LZajmi/Artix-7-FPGA-Dev-Board/ddr3.kicad_sch

## KiCad design ddr3.kicad_sch (2024-09-25)

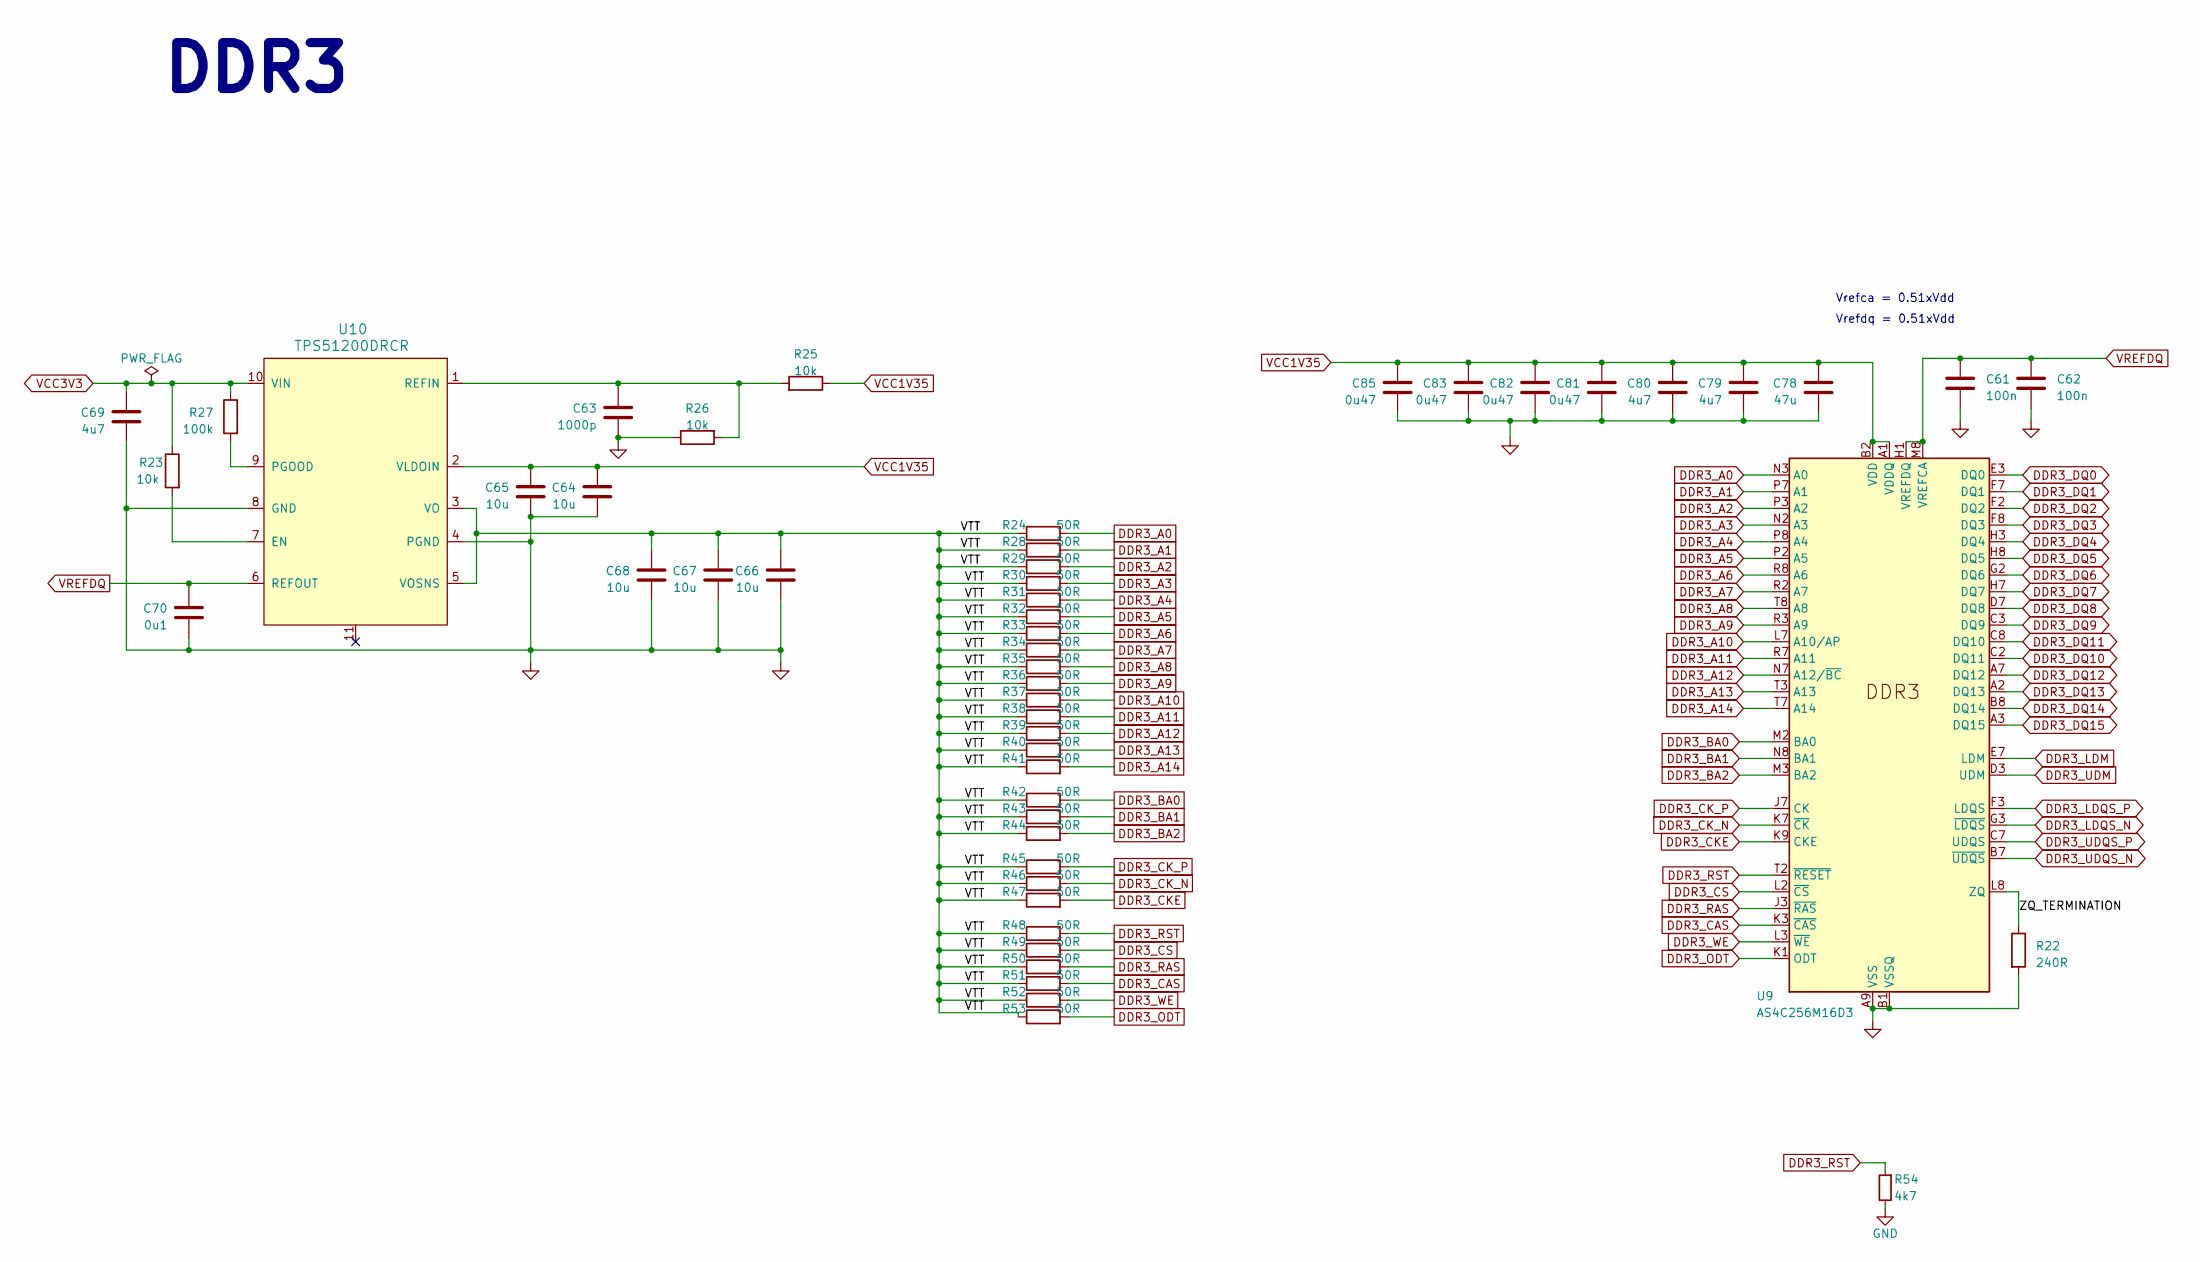
[picture p1: schematic ddr3.kicad_sch]

Parts:
C61, C62: 100n; G-155_MUR
C63: 1000p; CAP_GRM_155_MUR
C64, C65, C66, C67, C68: 10u; CAP_GRM155R60J106ME05D_MUR
C69, C79, C80: 4u7; CAPC2012X140N
C70: 0u1; G-155_MUR
C78: 47u; G-32_MUR
C81, C82, C83, C85: 0u47; CAPC1005X55N
R22: 240R; RES_ERA2AEB241X
R23, R25, R26: 10k; RESC1005X40N
R24, R28, R29, R30, R31, R32, R33, R34, R35, R36, R37, R38, R39, R40, R41, R42, R43, R44, R45, R46, R47, R48, R49, R50, R51, R52, R53: 50R; RESC1005X40N
R27: 100k; RESC1608X55
R54: R_4k7_0402; RESC1005X40; Tolerance 1%; MPN CR0402-FX-4701GLF
U9: AS4C256M16D3; BGA-96_9.0x13.0mm_Layout2x3x16_P0.8mm
U10: TPS51200DRCR; VSON-10-1EP_3x3mm; MPN TPS51200DRCR; Digi-Key_PN 296-26978-1-ND

Connections:
DDR3_A0: R24.2, U9.N3 (A0)
DDR3_A1: R28.2, U9.P7 (A1)
DDR3_A2: R29.2, U9.P3 (A2)
DDR3_A3: R30.2, U9.N2 (A3)
DDR3_A4: R31.2, U9.P8 (A4)
DDR3_A5: R32.2, U9.P2 (A5)
DDR3_A6: R33.2, U9.R8 (A6)
DDR3_A7: R34.2, U9.R2 (A7)
DDR3_A8: R35.2, U9.T8 (A8)
DDR3_A9: R36.2, U9.R3 (A9)
DDR3_A10: R37.2, U9.L7 (A10/AP)
DDR3_A11: R38.2, U9.R7 (A11)
DDR3_A12: R39.2, U9.N7 (A12/~BC)
DDR3_A13: R40.2, U9.T3 (A13)
DDR3_A14: R41.2, U9.T7 (A14)
DDR3_BA0: R42.2, U9.M2 (BA0)
DDR3_BA1: R43.2, U9.N8 (BA1)
DDR3_BA2: R44.2, U9.M3 (BA2)
DDR3_CAS: R51.2, U9.K3 (~CAS)
DDR3_CKE: R47.2, U9.K9 (CKE)
DDR3_CK_N: R46.2, U9.K7 (~CK)
DDR3_CK_P: R45.2, U9.J7 (CK)
DDR3_CS: R49.2, U9.L2 (~CS)
DDR3_DQ0: U9.E3 (DQ0)
DDR3_DQ1: U9.F7 (DQ1)
DDR3_DQ2: U9.F2 (DQ2)
DDR3_DQ3: U9.F8 (DQ3)
DDR3_DQ4: U9.H3 (DQ4)
DDR3_DQ5: U9.H8 (DQ5)
DDR3_DQ6: U9.G2 (DQ6)
DDR3_DQ7: U9.H7 (DQ7)
DDR3_DQ8: U9.D7 (DQ8)
DDR3_DQ9: U9.C3 (DQ9)
DDR3_DQ10: U9.C2 (DQ11)
DDR3_DQ11: U9.C8 (DQ10)
DDR3_DQ12: U9.A7 (DQ12)
DDR3_DQ13: U9.A2 (DQ13)
DDR3_DQ14: U9.B8 (DQ14)
DDR3_DQ15: U9.A3 (DQ15)
DDR3_LDM: U9.E7 (LDM)
DDR3_LDQS_N: U9.G3 (~LDQS)
DDR3_LDQS_P: U9.F3 (LDQS)
DDR3_ODT: R53.2, U9.K1 (ODT)
DDR3_RAS: R50.2, U9.J3 (~RAS)
DDR3_RST: R48.2, R54.1, U9.T2 (~RESET)
DDR3_UDM: U9.D3 (UDM)
DDR3_UDQS_N: U9.B7 (~UDQS)
DDR3_UDQS_P: U9.C7 (UDQS)
DDR3_WE: R52.2, U9.L3 (~WE)
GND: C61.2, C62.2, C63.2, C64.2, C65.2, C66.2, C67.2, C68.2, C69.2, C70.2, C78.1, C79.1, C80.1, C81.1, C82.1, C83.1, C85.1, R22.2, R26.1, R54.2, U9.A9 (VSS), U9.B1 (VSSQ), U9.B3 (VSS), U9.B9 (VSSQ), U9.D1 (VSSQ), U9.D8 (VSSQ), U9.E1 (VSS), U9.E2 (VSSQ), U9.E8 (VSSQ), U9.F9 (VSSQ), U9.G1 (VSSQ), U9.G8 (VSS), U9.G9 (VSSQ), U9.J2 (VSS), U9.J8 (VSS), U9.M1 (VSS), U9.M9 (VSS), U9.P1 (VSS), U9.P9 (VSS), U9.T1 (VSS), U9.T9 (VSS), U10.4 (PGND), U10.8 (GND)
unnamed: C63.1, R25.2, R26.2, U10.1 (REFIN)
unnamed: R23.2, U10.7 (EN)
unnamed: R27.2, U10.9 (PGOOD)
VCC1V35: C64.1, C65.1, C78.2, C79.2, C80.2, C81.2, C82.2, C83.2, C85.2, R25.1, U9.A1 (VDDQ), U9.A8 (VDDQ), U9.B2 (VDD), U9.C1 (VDDQ), U9.C9 (VDDQ), U9.D2 (VDDQ), U9.D9 (VDD), U9.E9 (VDDQ), U9.F1 (VDDQ), U9.G7 (VDD), U9.H2 (VDDQ), U9.H9 (VDDQ), U9.K2 (VDD), U9.K8 (VDD), U9.N1 (VDD), U9.N9 (VDD), U9.R1 (VDD), U9.R9 (VDD), U10.2 (VLDOIN)
VCC3V3: C69.1, R23.1, R27.1, U10.10 (VIN)
VREFDQ: C61.1, C62.1, C70.1, U9.H1 (VREFDQ), U9.M8 (VREFCA), U10.6 (REFOUT)
VTT: C66.1, C67.1, C68.1, R24.1, R28.1, R29.1, R30.1, R31.1, R32.1, R33.1, R34.1, R35.1, R36.1, R37.1, R38.1, R39.1, R40.1, R41.1, R42.1, R43.1, R44.1, R45.1, R46.1, R47.1, R48.1, R49.1, R50.1, R51.1, R52.1, R53.1, U10.3 (VO), U10.5 (VOSNS)
ZQ_TERMINATION: R22.1, U9.L8 (ZQ)

Notes on the sheet:
Vrefdq = 0.51xVdd
DDR3
Vrefca = 0.51xVdd
