LZajmi/Artix-7-FPGA-Dev-Board/ethernet.kicad_sch

## KiCad design ethernet.kicad_sch (2024-09-25)

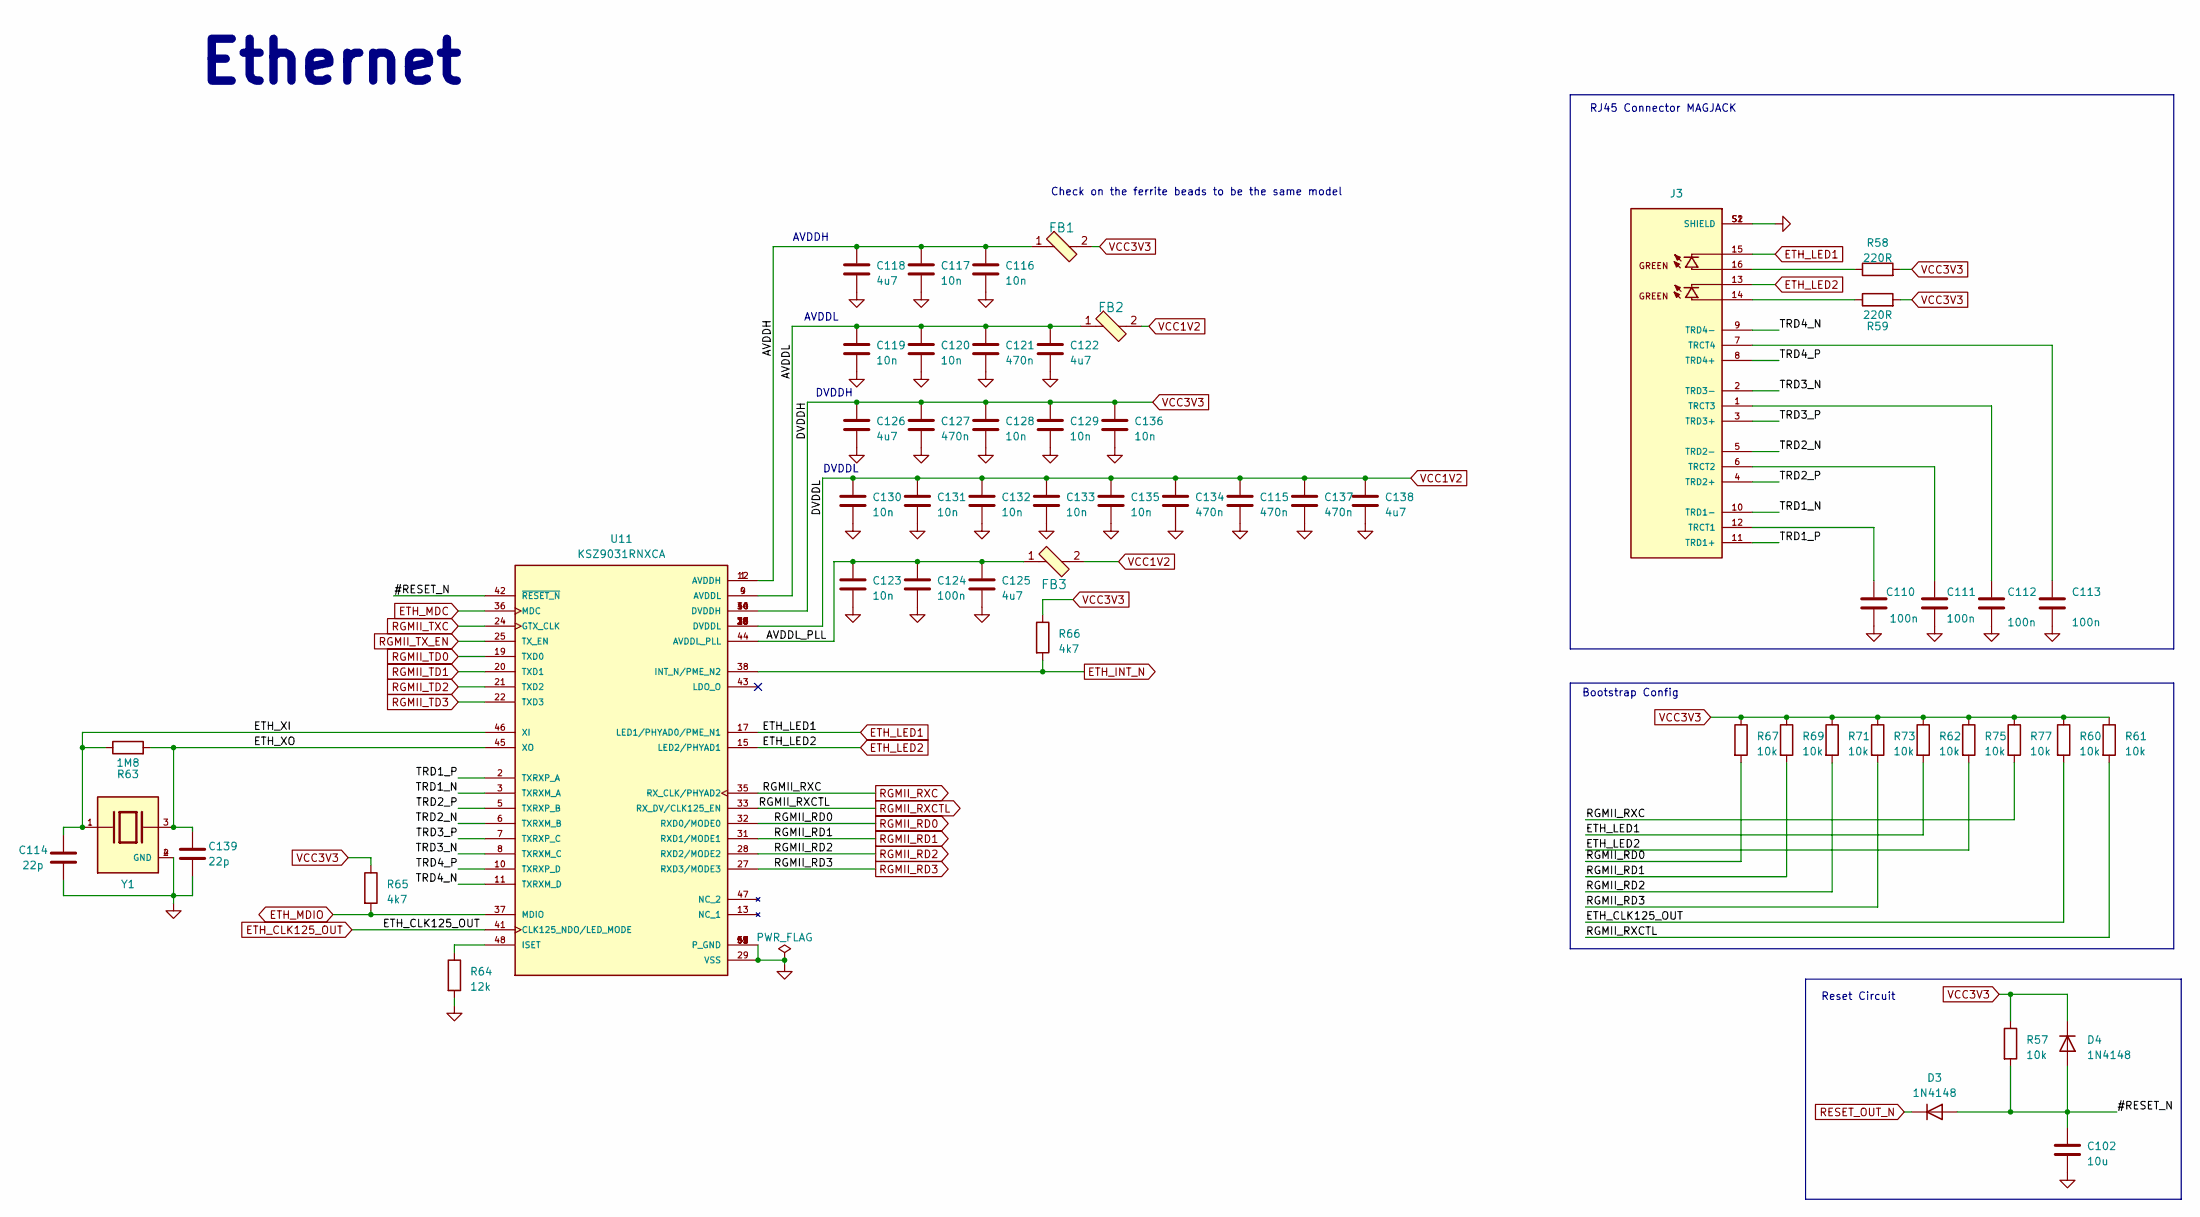
[picture p2: schematic ethernet.kicad_sch]

Parts:
C102: 10u; CAP_GRM155R60J106ME05D_MUR
C110, C111, C112, C113, C124: 100n; G-155_MUR
C114, C139: 22p; CAPC1005X55N
C115, C121, C127, C134, C137: 470n; CAPC1005X55N
C116, C117, C119, C120, C123, C128, C129, C130, C131, C132, C133, C135, C136: 10n; CAPC1005X55N
C118, C122, C125, C126, C138: 4u7; CAPC2012X140N
D3, D4: 1N4148; SOD123
FB1, FB2, FB3: BLM18PG121SN1D; IND_BLM18_0603_MUR; MPN BLM18PG121SN1D; Digi-Key_PN 490-1037-1-ND
J3: L834-1G1T-S7; BEL_L834-1G1T-S7
R57, R60, R61, R62, R67, R69, R71, R73, R75, R77: 10k; RESC1005X40N
R58, R59: 220R; RESC1005X35N
R63: 1M8; RESC1608X55N
R64: 12k; RESC1005X40N
R65, R66: 4k7; RESC1005X40
U11: KSZ9031RNXCA; QFN50P700X700X90-49N
Y1: ABM8G-27.000MHZ-18-D2Y-T; XTAL_ABM8G-27.000MHZ-18-D2Y-T; PARTREV 08.13.15

Connections:
#RESET_N: C102.1, D3.2 (A), D4.2 (A), R57.2, U11.42 (~RESET_N)
AVDDH: C116.1, C117.1, C118.1, FB1.1, U11.1 (AVDDH), U11.12 (AVDDH)
AVDDL: C119.1, C120.1, C121.1, C122.1, FB2.1, U11.4 (AVDDL), U11.9 (AVDDL)
AVDDL_PLL: C123.1, C124.1, C125.1, FB3.1, U11.44 (AVDDL_PLL)
ETH_CLK125_OUT: R60.2, U11.41 (CLK125_NDO/LED_MODE)
ETH_INT_N: R66.2, U11.38 (INT_N/PME_N2)
ETH_LED1: J3.15, R62.2, U11.17 (LED1/PHYAD0/PME_N1)
ETH_LED2: J3.13, R75.2, U11.15 (LED2/PHYAD1)
ETH_MDC: U11.36 (MDC)
ETH_MDIO: R65.2, U11.37 (MDIO)
ETH_XI: C114.1, R63.1, U11.46 (XI), Y1.1
ETH_XO: C139.1, R63.2, U11.45 (XO), Y1.3
GND: C102.2, C110.2, C111.2, C112.2, C113.2, C114.2, C115.2, C116.2, C117.2, C118.2, C119.2, C120.2, C121.2, C122.2, C123.2, C124.2, C125.2, C126.2, C127.2, C128.2, C129.2, C130.2, C131.2, C132.2, C133.2, C134.2, C135.2, C136.2, C137.2, C138.2, C139.2, J3.S1 (SHIELD), J3.S2 (SHIELD), R64.2, U11.29 (VSS), U11.49 (P_GND), U11.50 (P_GND), U11.51 (P_GND), U11.52 (P_GND), U11.53 (P_GND), Y1.2 (GND), Y1.4 (GND)
unnamed: C110.1, J3.12 (TRCT1)
unnamed: C111.1, J3.6 (TRCT2)
unnamed: C112.1, J3.1 (TRCT3)
unnamed: C113.1, J3.7 (TRCT4)
unnamed: J3.14, R59.1
unnamed: J3.16, R58.1
unnamed: R64.1, U11.48 (ISET)
RESET_OUT_N: D3.1 (K)
RGMII_RD0: R67.2, U11.32 (RXD0/MODE0)
RGMII_RD1: R69.2, U11.31 (RXD1/MODE1)
RGMII_RD2: R71.2, U11.28 (RXD2/MODE2)
RGMII_RD3: R73.2, U11.27 (RXD3/MODE3)
RGMII_RXC: R77.2, U11.35 (RX_CLK/PHYAD2)
RGMII_RXCTL: R61.2, U11.33 (RX_DV/CLK125_EN)
RGMII_TD0: U11.19 (TXD0)
RGMII_TD1: U11.20 (TXD1)
RGMII_TD2: U11.21 (TXD2)
RGMII_TD3: U11.22 (TXD3)
RGMII_TXC: U11.24 (GTX_CLK)
RGMII_TX_EN: U11.25 (TX_EN)
TRD1_N: J3.10 (TRD1-), U11.3 (TXRXM_A)
TRD1_P: J3.11 (TRD1+), U11.2 (TXRXP_A)
TRD2_N: J3.5 (TRD2-), U11.6 (TXRXM_B)
TRD2_P: J3.4 (TRD2+), U11.5 (TXRXP_B)
TRD3_N: J3.2 (TRD3-), U11.8 (TXRXM_C)
TRD3_P: J3.3 (TRD3+), U11.7 (TXRXP_C)
TRD4_N: J3.9 (TRD4-), U11.11 (TXRXM_D)
TRD4_P: J3.8 (TRD4+), U11.10 (TXRXP_D)
VCC1V2: C115.1, C130.1, C131.1, C132.1, C133.1, C134.1, C135.1, C137.1, C138.1, FB2.2, FB3.2, U11.14 (DVDDL), U11.18 (DVDDL), U11.23 (DVDDL), U11.26 (DVDDL), U11.30 (DVDDL), U11.39 (DVDDL)
VCC3V3: C126.1, C127.1, C128.1, C129.1, C136.1, D4.1 (K), FB1.2, R57.1, R58.2, R59.2, R60.1, R61.1, R62.1, R65.1, R66.1, R67.1, R69.1, R71.1, R73.1, R75.1, R77.1, U11.16 (DVDDH), U11.34 (DVDDH), U11.40 (DVDDH)

Notes on the sheet:
AVDDL
DVDDL
Reset Circuit
Bootstrap Config
AVDDH
Ethernet
Check on the ferrite beads to be the same model
DVDDH
RJ45 Connector MAGJACK
