LZajmi/Artix-7-FPGA-Dev-Board/fpga-banks-13-16.kicad_sch

## KiCad design fpga-banks-13-16.kicad_sch (2024-09-25)

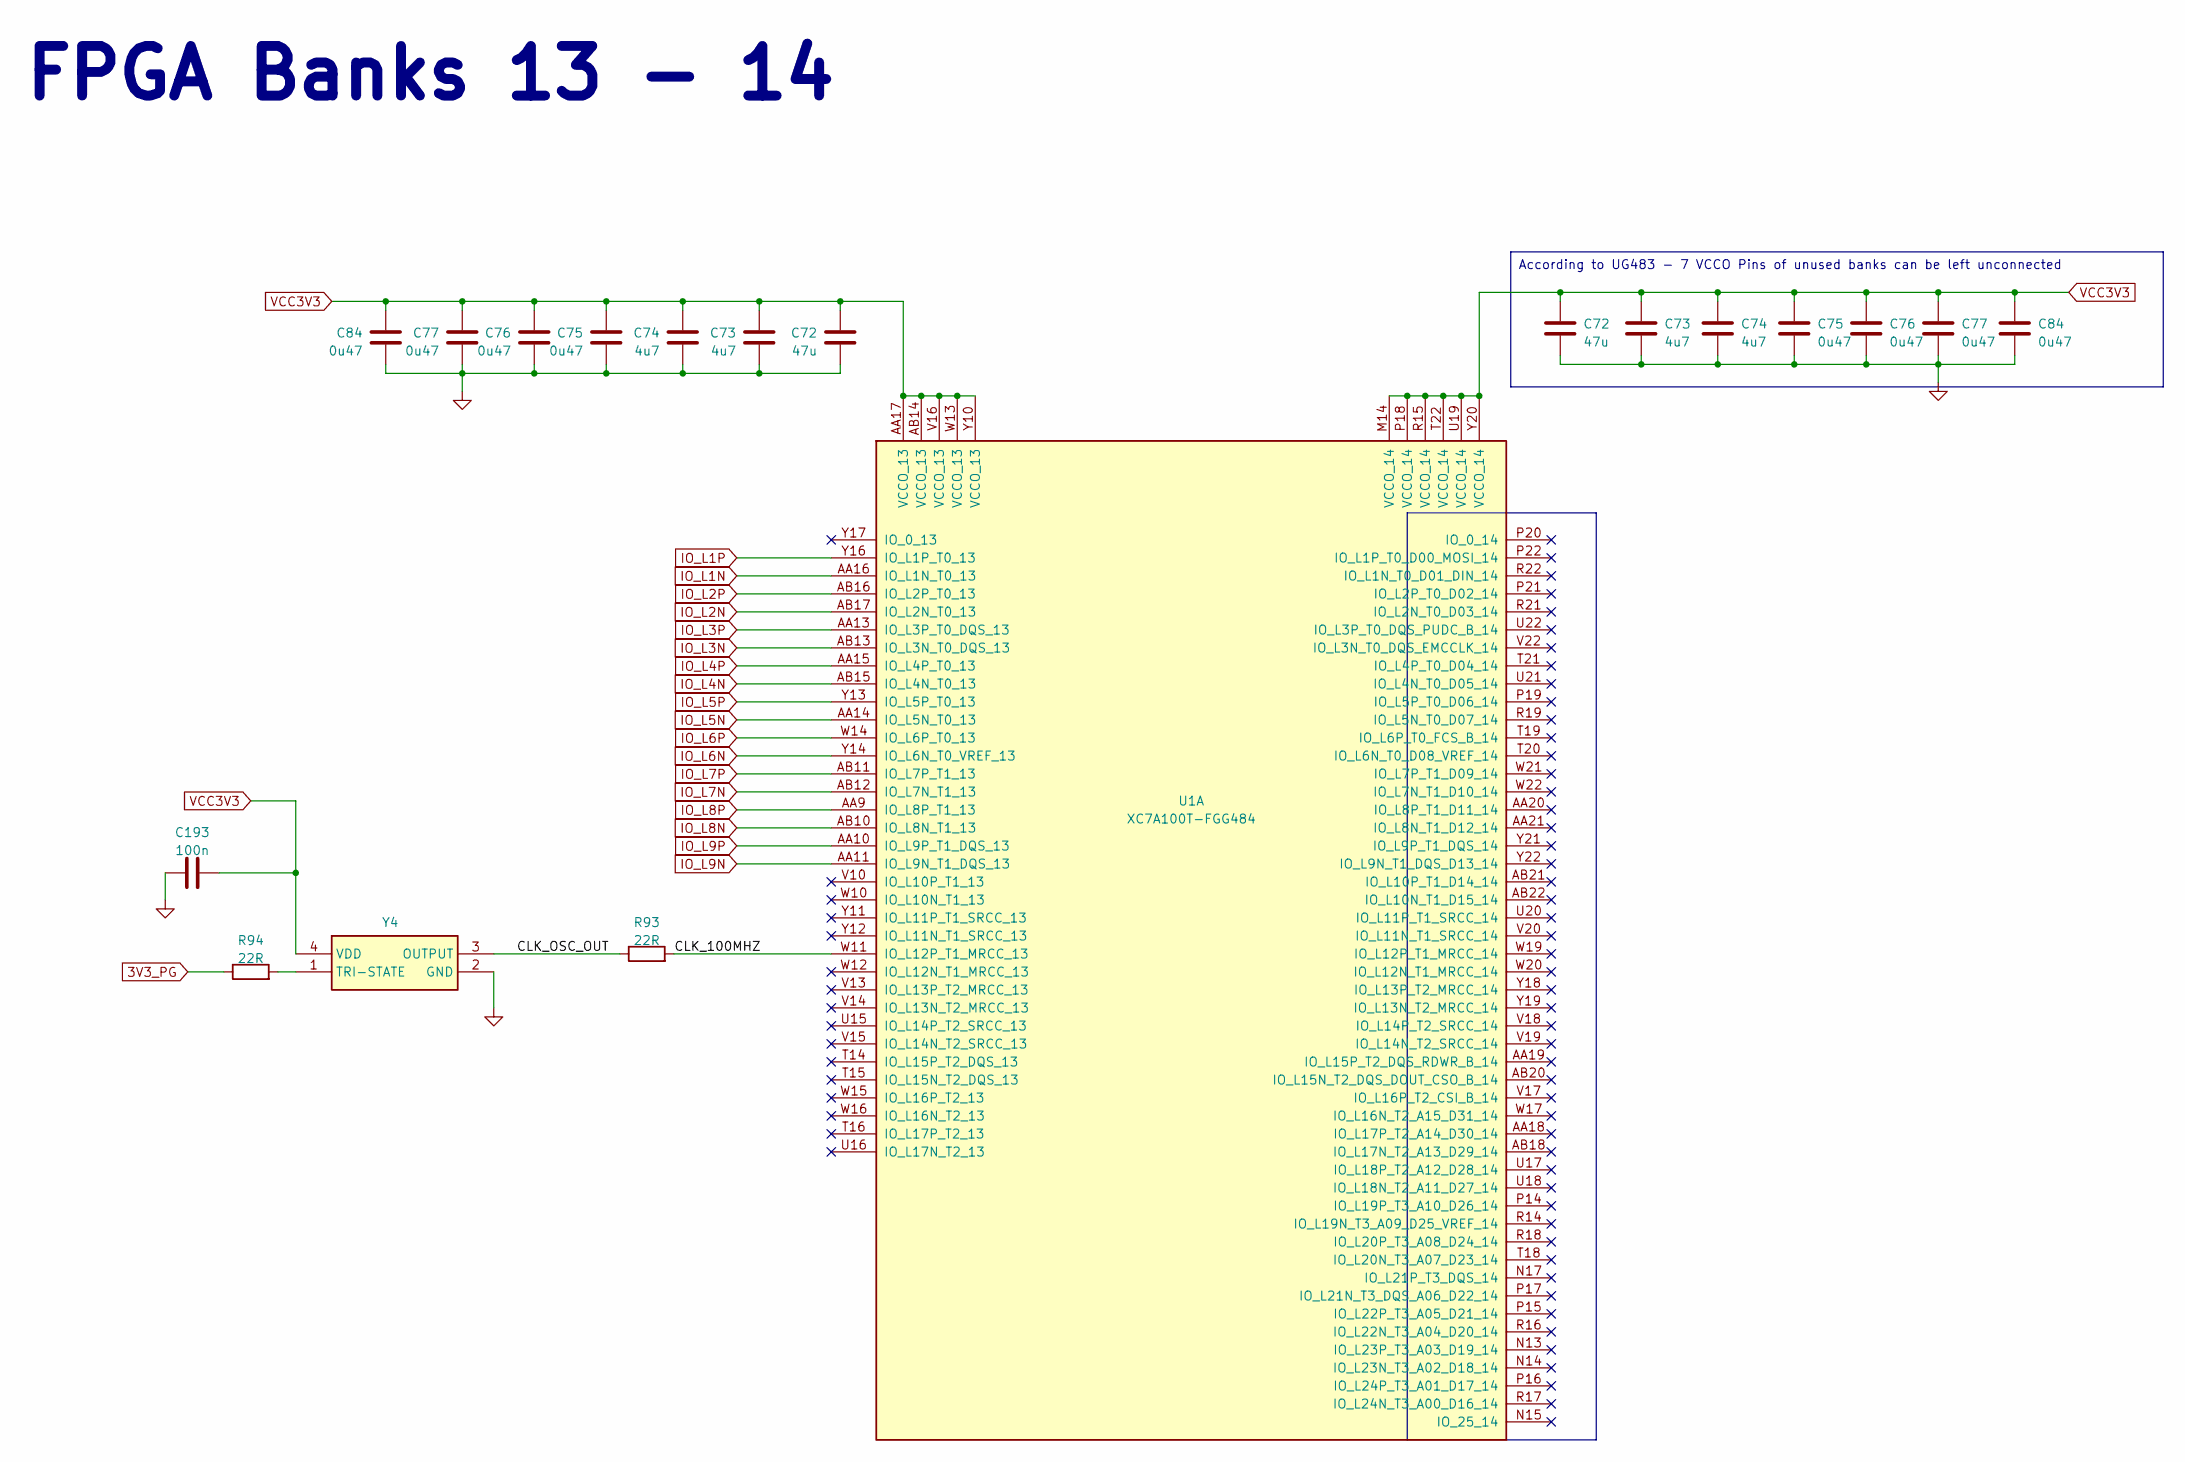
[picture p3: schematic fpga-banks-13-16.kicad_sch]

Parts:
C72: 47u; G-32_MUR
C73, C74: 4u7; CAPC2012X140N
C75, C76, C77, C84: 0u47; CAPC1005X55N
C193: 100n; G-155_MUR
R93, R94: 22R; RC0402N_YAG
U1: XC7A100T-FGG484; BGA484C100P22X22_2300X2300X260N
Y4: ECS-2520MV-130-BN-TR; ECS2520MV130BNTR; Mouser Part Number 520-S2520MV130BNTR

Connections:
3V3_PG: R94.1
CLK_100MHZ: R93.2, U1.W11 (IO_L12P_T1_MRCC_13)
CLK_OSC_OUT: R93.1, Y4.3 (OUTPUT)
GND: C72.1, C73.1, C74.1, C75.1, C76.1, C77.1, C84.1, C193.1, Y4.2 (GND)
IO_L1N: U1.AA16 (IO_L1N_T0_13)
IO_L1P: U1.Y16 (IO_L1P_T0_13)
IO_L2N: U1.AB17 (IO_L2N_T0_13)
IO_L2P: U1.AB16 (IO_L2P_T0_13)
IO_L3N: U1.AB13 (IO_L3N_T0_DQS_13)
IO_L3P: U1.AA13 (IO_L3P_T0_DQS_13)
IO_L4N: U1.AB15 (IO_L4N_T0_13)
IO_L4P: U1.AA15 (IO_L4P_T0_13)
IO_L5N: U1.AA14 (IO_L5N_T0_13)
IO_L5P: U1.Y13 (IO_L5P_T0_13)
IO_L6N: U1.Y14 (IO_L6N_T0_VREF_13)
IO_L6P: U1.W14 (IO_L6P_T0_13)
IO_L7N: U1.AB12 (IO_L7N_T1_13)
IO_L7P: U1.AB11 (IO_L7P_T1_13)
IO_L8N: U1.AB10 (IO_L8N_T1_13)
IO_L8P: U1.AA9 (IO_L8P_T1_13)
IO_L9N: U1.AA11 (IO_L9N_T1_DQS_13)
IO_L9P: U1.AA10 (IO_L9P_T1_DQS_13)
unnamed: R94.2, Y4.1 (TRI-STATE)
VCC3V3: C72.2, C73.2, C74.2, C75.2, C76.2, C77.2, C84.2, C193.2, U1.AA17 (VCCO_13), U1.AB14 (VCCO_13), U1.M14 (VCCO_14), U1.P18 (VCCO_14), U1.R15 (VCCO_14), U1.T22 (VCCO_14), U1.U19 (VCCO_14), U1.V16 (VCCO_13), U1.W13 (VCCO_13), U1.Y10 (VCCO_13), U1.Y20 (VCCO_14), Y4.4 (VDD)

Notes on the sheet:
According to UG483 - 7 VCCO Pins of unused banks can be left unconnected
FPGA Banks 13 - 14
