LZajmi/Artix-7-FPGA-Dev-Board/fpga-unit-b.kicad_sch

## KiCad design fpga-unit-b.kicad_sch (2024-09-25)

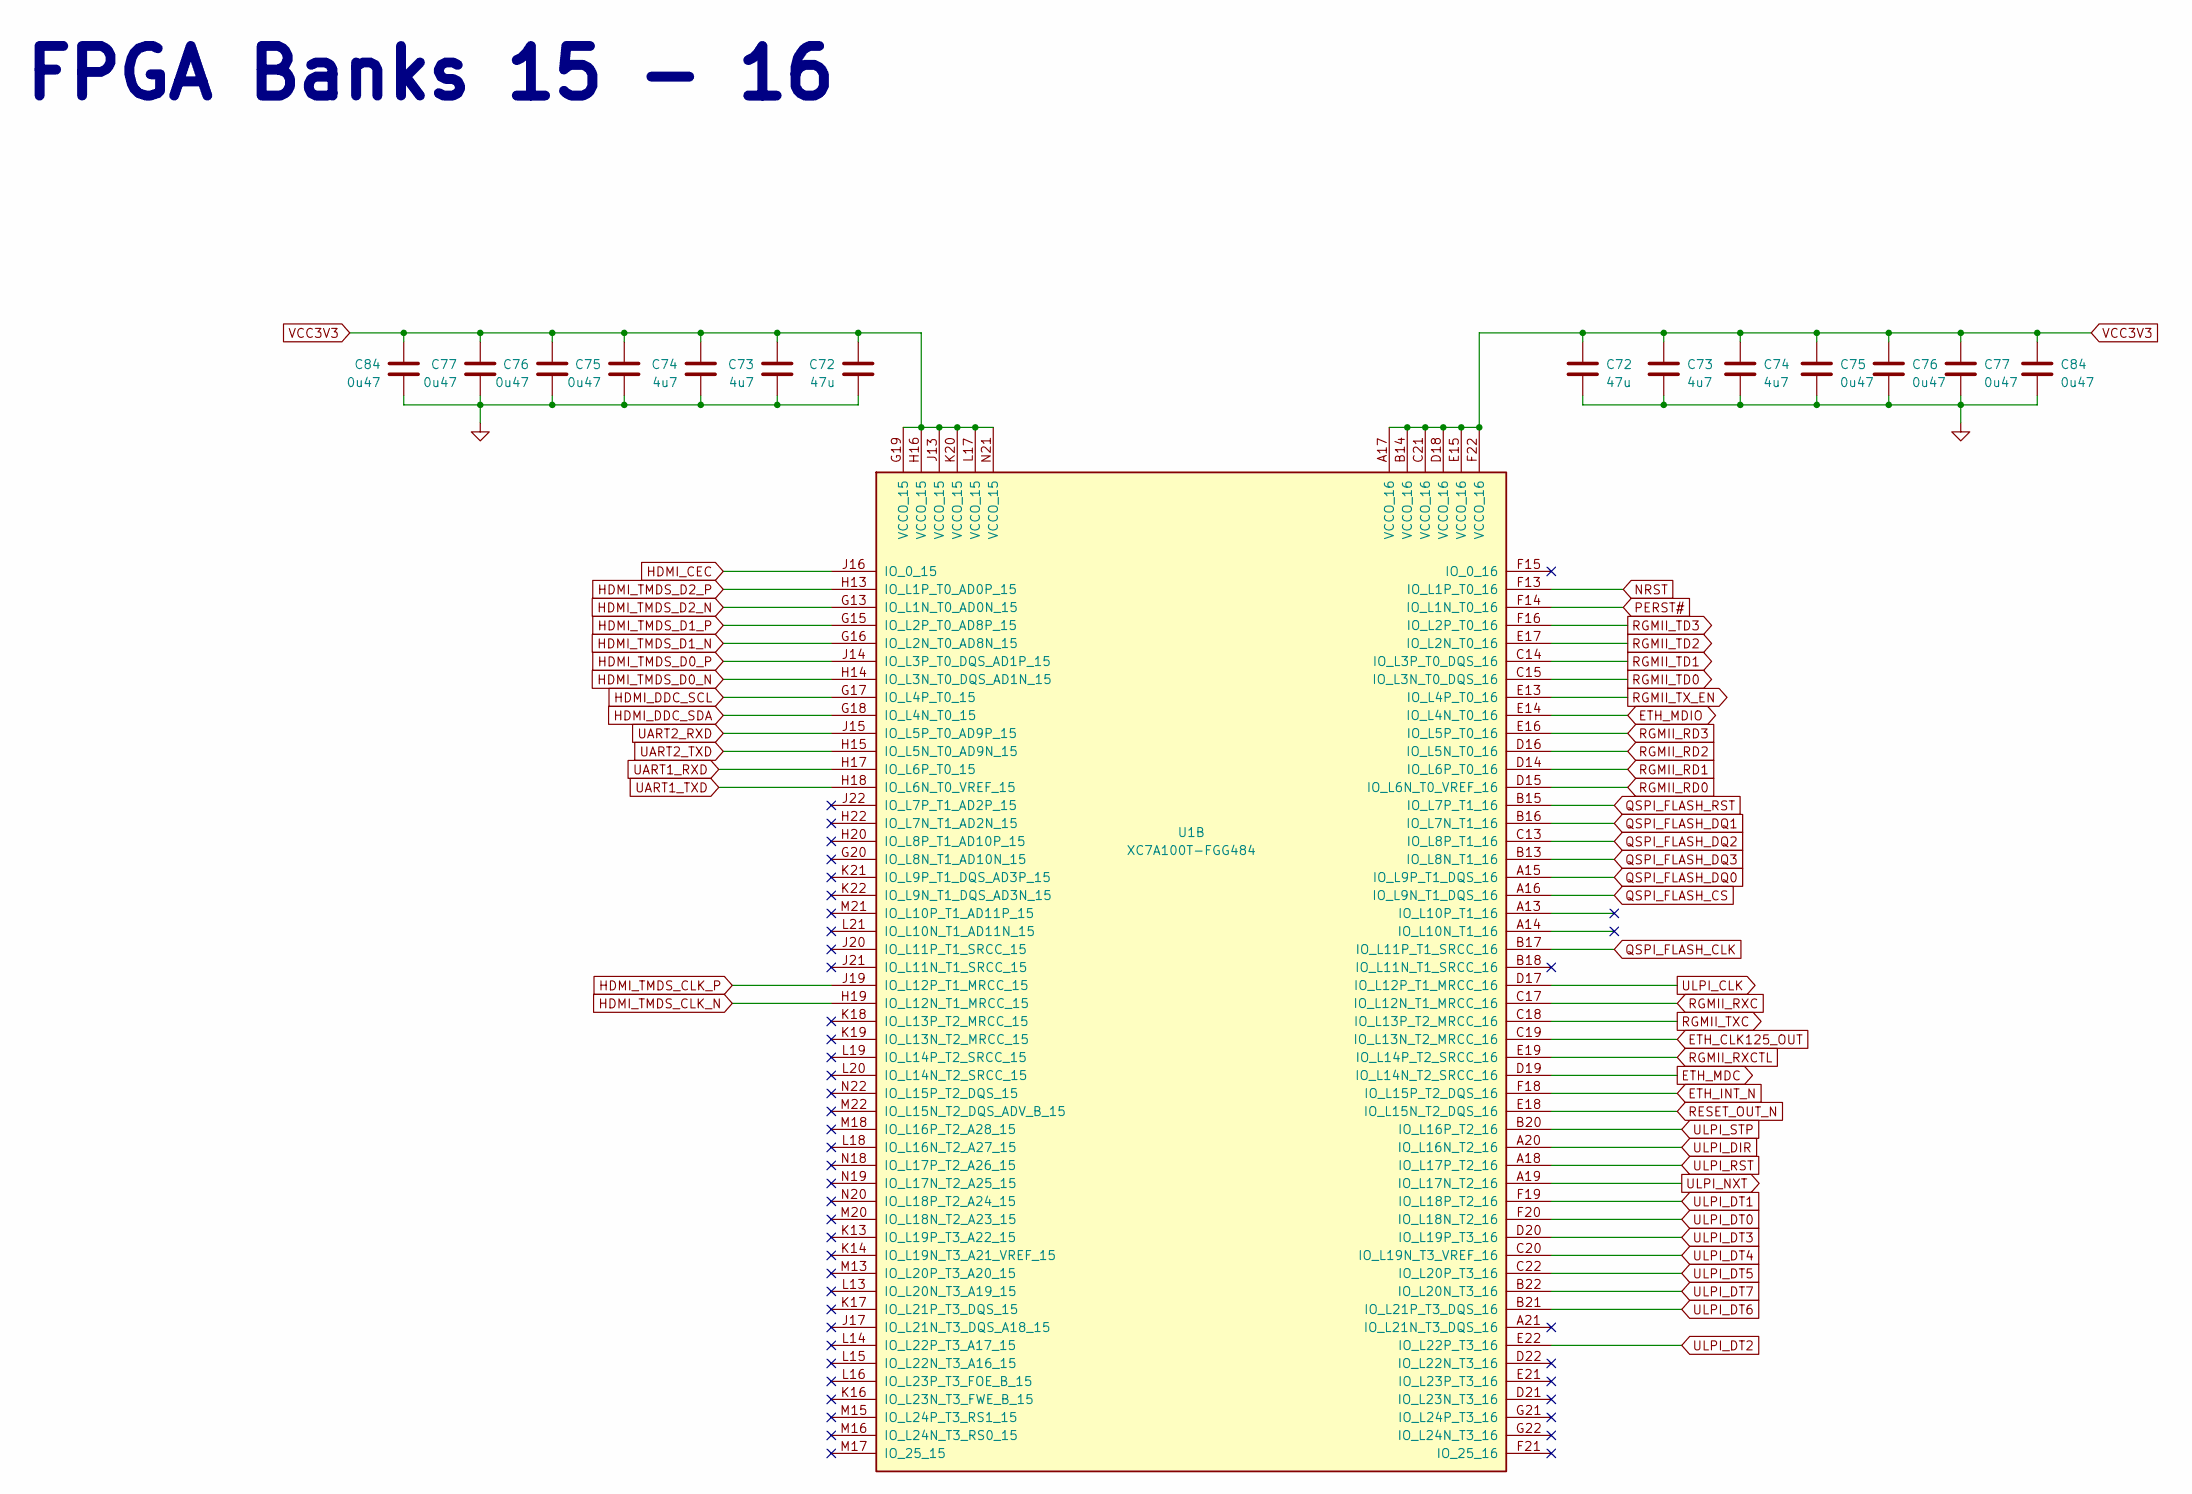
[picture p4: schematic fpga-unit-b.kicad_sch]

Parts:
C72: 47u; G-32_MUR
C73, C74: 4u7; CAPC2012X140N
C75, C76, C77, C84: 0u47; CAPC1005X55N
U1: XC7A100T-FGG484; BGA484C100P22X22_2300X2300X260N

Connections:
ETH_CLK125_OUT: U1.C19 (IO_L13N_T2_MRCC_16)
ETH_INT_N: U1.F18 (IO_L15P_T2_DQS_16)
ETH_MDC: U1.D19 (IO_L14N_T2_SRCC_16)
ETH_MDIO: U1.E14 (IO_L4N_T0_16)
GND: C72.1, C73.1, C74.1, C75.1, C76.1, C77.1, C84.1
HDMI_CEC: U1.J16 (IO_0_15)
HDMI_DDC_SCL: U1.G17 (IO_L4P_T0_15)
HDMI_DDC_SDA: U1.G18 (IO_L4N_T0_15)
HDMI_TMDS_CLK_N: U1.H19 (IO_L12N_T1_MRCC_15)
HDMI_TMDS_CLK_P: U1.J19 (IO_L12P_T1_MRCC_15)
HDMI_TMDS_D0_N: U1.H14 (IO_L3N_T0_DQS_AD1N_15)
HDMI_TMDS_D0_P: U1.J14 (IO_L3P_T0_DQS_AD1P_15)
HDMI_TMDS_D1_N: U1.G16 (IO_L2N_T0_AD8N_15)
HDMI_TMDS_D1_P: U1.G15 (IO_L2P_T0_AD8P_15)
HDMI_TMDS_D2_N: U1.G13 (IO_L1N_T0_AD0N_15)
HDMI_TMDS_D2_P: U1.H13 (IO_L1P_T0_AD0P_15)
NRST: U1.F13 (IO_L1P_T0_16)
PERST#: U1.F14 (IO_L1N_T0_16)
QSPI_FLASH_CLK: U1.B17 (IO_L11P_T1_SRCC_16)
QSPI_FLASH_CS: U1.A16 (IO_L9N_T1_DQS_16)
QSPI_FLASH_DQ0: U1.A15 (IO_L9P_T1_DQS_16)
QSPI_FLASH_DQ1: U1.B16 (IO_L7N_T1_16)
QSPI_FLASH_DQ2: U1.C13 (IO_L8P_T1_16)
QSPI_FLASH_DQ3: U1.B13 (IO_L8N_T1_16)
QSPI_FLASH_RST: U1.B15 (IO_L7P_T1_16)
RESET_OUT_N: U1.E18 (IO_L15N_T2_DQS_16)
RGMII_RD0: U1.D15 (IO_L6N_T0_VREF_16)
RGMII_RD1: U1.D14 (IO_L6P_T0_16)
RGMII_RD2: U1.D16 (IO_L5N_T0_16)
RGMII_RD3: U1.E16 (IO_L5P_T0_16)
RGMII_RXC: U1.C17 (IO_L12N_T1_MRCC_16)
RGMII_RXCTL: U1.E19 (IO_L14P_T2_SRCC_16)
RGMII_TD0: U1.C15 (IO_L3N_T0_DQS_16)
RGMII_TD1: U1.C14 (IO_L3P_T0_DQS_16)
RGMII_TD2: U1.E17 (IO_L2N_T0_16)
RGMII_TD3: U1.F16 (IO_L2P_T0_16)
RGMII_TXC: U1.C18 (IO_L13P_T2_MRCC_16)
RGMII_TX_EN: U1.E13 (IO_L4P_T0_16)
UART1_RXD: U1.H17 (IO_L6P_T0_15)
UART1_TXD: U1.H18 (IO_L6N_T0_VREF_15)
UART2_RXD: U1.J15 (IO_L5P_T0_AD9P_15)
UART2_TXD: U1.H15 (IO_L5N_T0_AD9N_15)
ULPI_CLK: U1.D17 (IO_L12P_T1_MRCC_16)
ULPI_DIR: U1.A20 (IO_L16N_T2_16)
ULPI_DT0: U1.F20 (IO_L18N_T2_16)
ULPI_DT1: U1.F19 (IO_L18P_T2_16)
ULPI_DT2: U1.E22 (IO_L22P_T3_16)
ULPI_DT3: U1.D20 (IO_L19P_T3_16)
ULPI_DT4: U1.C20 (IO_L19N_T3_VREF_16)
ULPI_DT5: U1.C22 (IO_L20P_T3_16)
ULPI_DT6: U1.B21 (IO_L21P_T3_DQS_16)
ULPI_DT7: U1.B22 (IO_L20N_T3_16)
ULPI_NXT: U1.A19 (IO_L17N_T2_16)
ULPI_RST: U1.A18 (IO_L17P_T2_16)
ULPI_STP: U1.B20 (IO_L16P_T2_16)
VCC3V3: C72.2, C73.2, C74.2, C75.2, C76.2, C77.2, C84.2, U1.A17 (VCCO_16), U1.B14 (VCCO_16), U1.C21 (VCCO_16), U1.D18 (VCCO_16), U1.E15 (VCCO_16), U1.F22 (VCCO_16), U1.G19 (VCCO_15), U1.H16 (VCCO_15), U1.J13 (VCCO_15), U1.K20 (VCCO_15), U1.L17 (VCCO_15), U1.N21 (VCCO_15)

Notes on the sheet:
FPGA Banks 15 - 16
