LZajmi/Artix-7-FPGA-Dev-Board/fpga-unit-c.kicad_sch

## KiCad design fpga-unit-c.kicad_sch (2024-09-25)

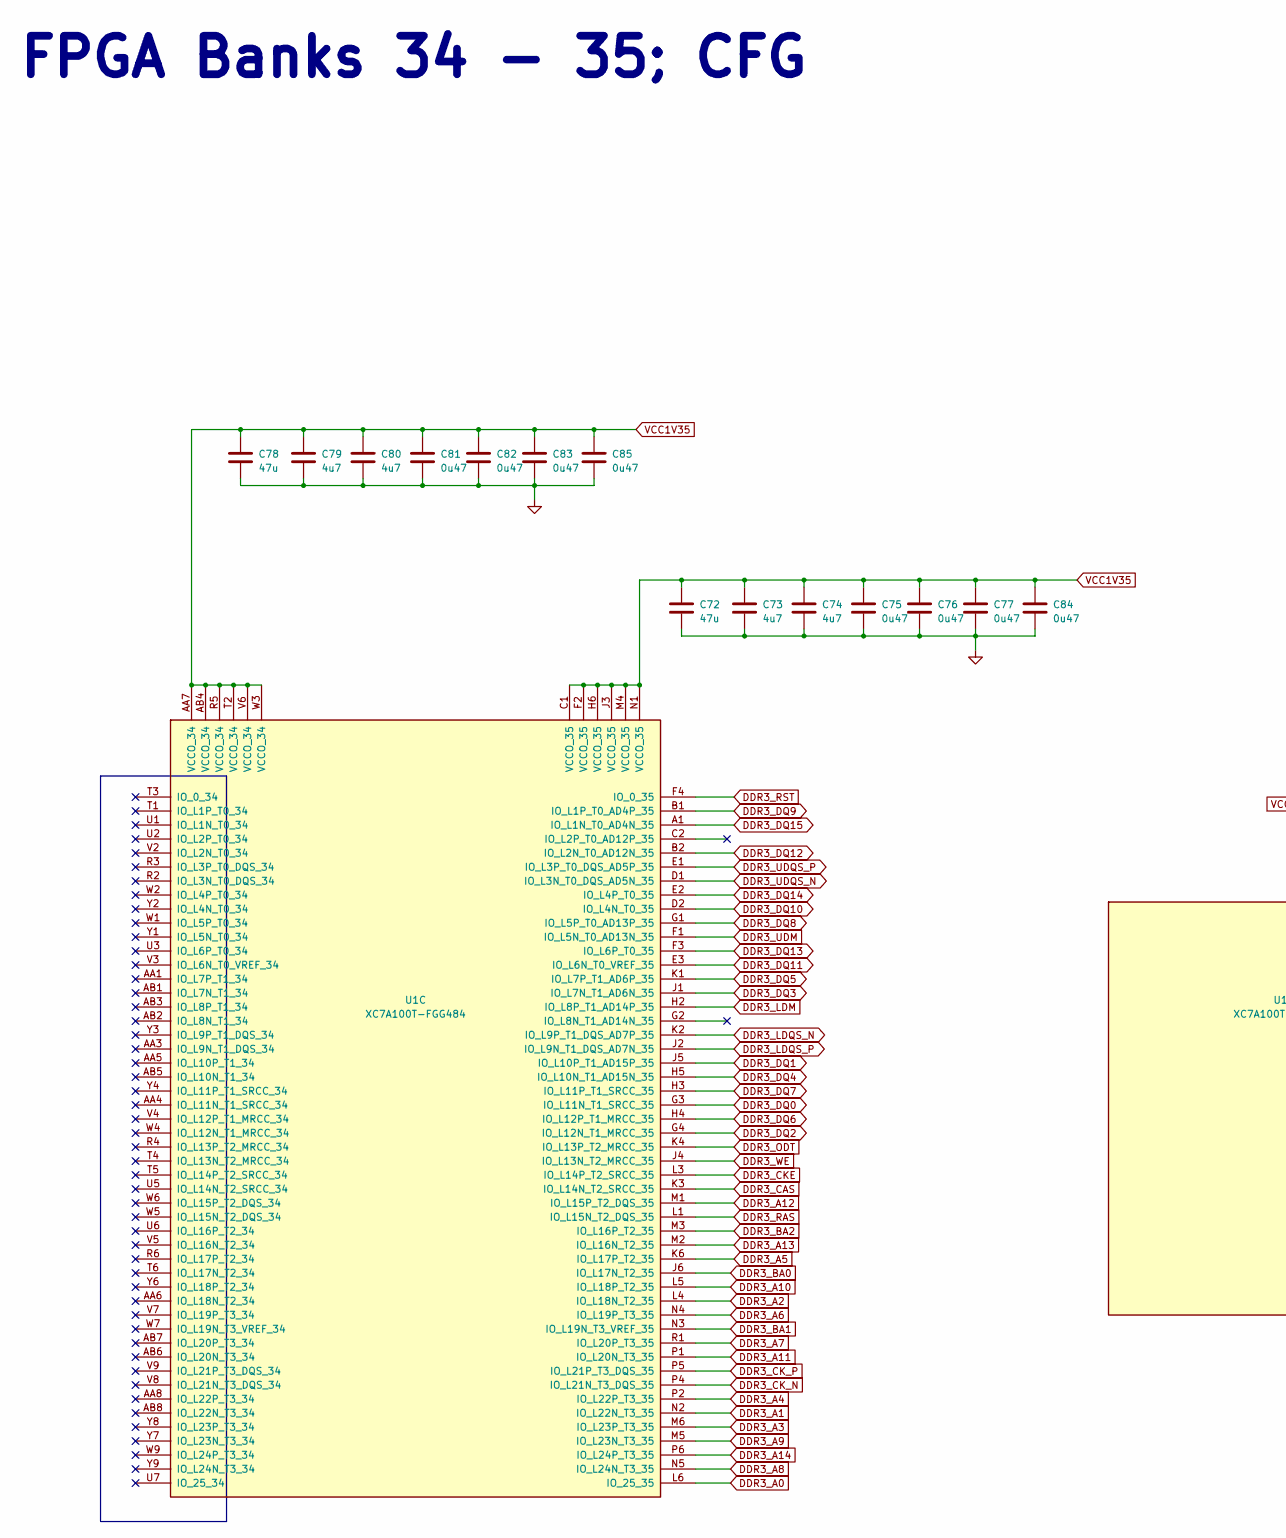
[picture p5: schematic fpga-unit-c.kicad_sch, part in row 1, column 1]

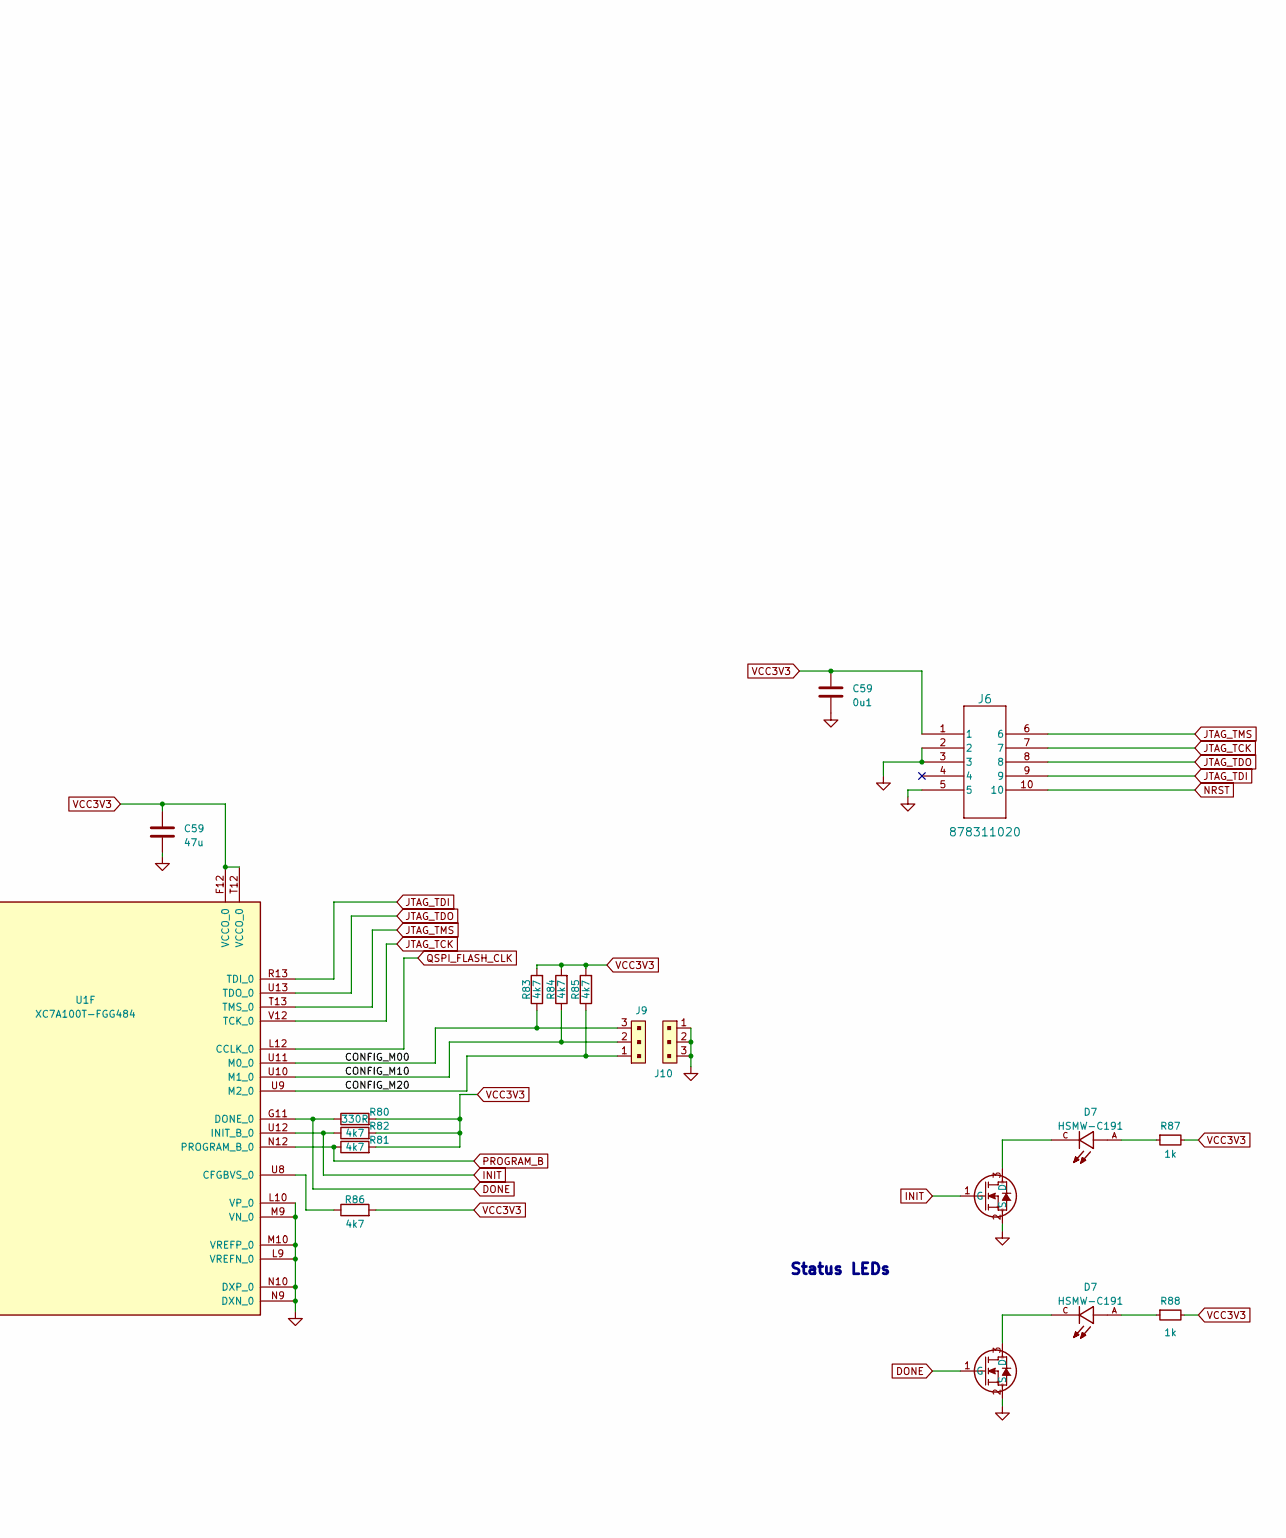
[picture p6: schematic fpga-unit-c.kicad_sch, part in row 1, column 2]

Parts:
C59, C72, C78: 47u; G-32_MUR
C73, C74, C79, C80: 4u7; CAPC2012X140N
C75, C76, C77, C81, C82, C83, C84, C85: 0u47; CAPC1005X55N
D7: HSMW-C191; LEDSC80X160X70-2N; PARTREV N/A
J6: 878311020; 87831-1020_MOL
J9, J10: 640456-3; PinHeader_1x3_P2.54_Drill1.1mm; MPN 640456-3; Digi-Key_PN A19470-ND
MOSFET4, MOSFET5: 2N7002; SOT-23TO-236_318-08_ONS
R80: 330R; RC0402N_YAG
R81, R82, R83, R84, R85, R86: 4k7; RESC1005X40
R87, R88: R_1k_0402; RESC1607X60N; Tolerance 1%; MPN CR0402-FX-1001GLF
U1: XC7A100T-FGG484; BGA484C100P22X22_2300X2300X260N

Connections:
CONFIG_M00: J9.3, R83.1, U1.U11 (M0_0)
CONFIG_M10: J9.2, R84.1, U1.U10 (M1_0)
CONFIG_M20: J9.1, R85.1, U1.U9 (M2_0)
DDR3_A0: U1.L6 (IO_25_35)
DDR3_A1: U1.N2 (IO_L22N_T3_35)
DDR3_A2: U1.L4 (IO_L18N_T2_35)
DDR3_A3: U1.M6 (IO_L23P_T3_35)
DDR3_A4: U1.P2 (IO_L22P_T3_35)
DDR3_A5: U1.K6 (IO_L17P_T2_35)
DDR3_A6: U1.N4 (IO_L19P_T3_35)
DDR3_A7: U1.R1 (IO_L20P_T3_35)
DDR3_A8: U1.N5 (IO_L24N_T3_35)
DDR3_A9: U1.M5 (IO_L23N_T3_35)
DDR3_A10: U1.L5 (IO_L18P_T2_35)
DDR3_A11: U1.P1 (IO_L20N_T3_35)
DDR3_A12: U1.M1 (IO_L15P_T2_DQS_35)
DDR3_A13: U1.M2 (IO_L16N_T2_35)
DDR3_A14: U1.P6 (IO_L24P_T3_35)
DDR3_BA0: U1.J6 (IO_L17N_T2_35)
DDR3_BA1: U1.N3 (IO_L19N_T3_VREF_35)
DDR3_BA2: U1.M3 (IO_L16P_T2_35)
DDR3_CAS: U1.K3 (IO_L14N_T2_SRCC_35)
DDR3_CKE: U1.L3 (IO_L14P_T2_SRCC_35)
DDR3_CK_N: U1.P4 (IO_L21N_T3_DQS_35)
DDR3_CK_P: U1.P5 (IO_L21P_T3_DQS_35)
DDR3_DQ0: U1.G3 (IO_L11N_T1_SRCC_35)
DDR3_DQ1: U1.J5 (IO_L10P_T1_AD15P_35)
DDR3_DQ2: U1.G4 (IO_L12N_T1_MRCC_35)
DDR3_DQ3: U1.J1 (IO_L7N_T1_AD6N_35)
DDR3_DQ4: U1.H5 (IO_L10N_T1_AD15N_35)
DDR3_DQ5: U1.K1 (IO_L7P_T1_AD6P_35)
DDR3_DQ6: U1.H4 (IO_L12P_T1_MRCC_35)
DDR3_DQ7: U1.H3 (IO_L11P_T1_SRCC_35)
DDR3_DQ8: U1.G1 (IO_L5P_T0_AD13P_35)
DDR3_DQ9: U1.B1 (IO_L1P_T0_AD4P_35)
DDR3_DQ10: U1.D2 (IO_L4N_T0_35)
DDR3_DQ11: U1.E3 (IO_L6N_T0_VREF_35)
DDR3_DQ12: U1.B2 (IO_L2N_T0_AD12N_35)
DDR3_DQ13: U1.F3 (IO_L6P_T0_35)
DDR3_DQ14: U1.E2 (IO_L4P_T0_35)
DDR3_DQ15: U1.A1 (IO_L1N_T0_AD4N_35)
DDR3_LDM: U1.H2 (IO_L8P_T1_AD14P_35)
DDR3_LDQS_N: U1.K2 (IO_L9P_T1_DQS_AD7P_35)
DDR3_LDQS_P: U1.J2 (IO_L9N_T1_DQS_AD7N_35)
DDR3_ODT: U1.K4 (IO_L13P_T2_MRCC_35)
DDR3_RAS: U1.L1 (IO_L15N_T2_DQS_35)
DDR3_RST: U1.F4 (IO_0_35)
DDR3_UDM: U1.F1 (IO_L5N_T0_AD13N_35)
DDR3_UDQS_N: U1.D1 (IO_L3N_T0_DQS_AD5N_35)
DDR3_UDQS_P: U1.E1 (IO_L3P_T0_DQS_AD5P_35)
DDR3_WE: U1.J4 (IO_L13N_T2_MRCC_35)
DONE: MOSFET5.1 (G), R80.1, U1.G11 (DONE_0)
GND: C59.2, C72.1, C73.1, C74.1, C75.1, C76.1, C77.1, C78.1, C79.1, C80.1, C81.1, C82.1, C83.1, C84.1, C85.1, J6.2, J6.3, J6.5, J10.1, J10.2, J10.3, MOSFET4.2 (S), MOSFET5.2 (S), U1.L9 (VREFN_0), U1.L10 (VP_0), U1.M9 (VN_0), U1.M10 (VREFP_0), U1.N9 (DXN_0), U1.N10 (DXP_0)
INIT: MOSFET4.1 (G), R82.1, U1.U12 (INIT_B_0)
JTAG_TCK: J6.7, U1.V12 (TCK_0)
JTAG_TDI: J6.9, U1.R13 (TDI_0)
JTAG_TDO: J6.8, U1.U13 (TDO_0)
JTAG_TMS: J6.6, U1.T13 (TMS_0)
NRST: J6.10
unnamed: D7.A, R87.1, R88.1
unnamed: D7.C, MOSFET4.3 (D), MOSFET5.3 (D)
unnamed: R86.1, U1.U8 (CFGBVS_0)
PROGRAM_B: R81.1, U1.N12 (PROGRAM_B_0)
QSPI_FLASH_CLK: U1.L12 (CCLK_0)
VCC1V35: C72.2, C73.2, C74.2, C75.2, C76.2, C77.2, C78.2, C79.2, C80.2, C81.2, C82.2, C83.2, C84.2, C85.2, U1.AA7 (VCCO_34), U1.AB4 (VCCO_34), U1.C1 (VCCO_35), U1.F2 (VCCO_35), U1.H6 (VCCO_35), U1.J3 (VCCO_35), U1.M4 (VCCO_35), U1.N1 (VCCO_35), U1.R5 (VCCO_34), U1.T2 (VCCO_34), U1.V6 (VCCO_34), U1.W3 (VCCO_34)
VCC3V3: C59.1, J6.1, R80.2, R81.2, R82.2, R83.2, R84.2, R85.2, R86.2, R87.2, R88.2, U1.F12 (VCCO_0), U1.T12 (VCCO_0)

Notes on the sheet:
FPGA Banks 34 - 35; CFG
Status LEDs
