LZajmi/Artix-7-FPGA-Dev-Board/fpga-unit-d.kicad_sch

## KiCad design fpga-unit-d.kicad_sch (2024-09-25)

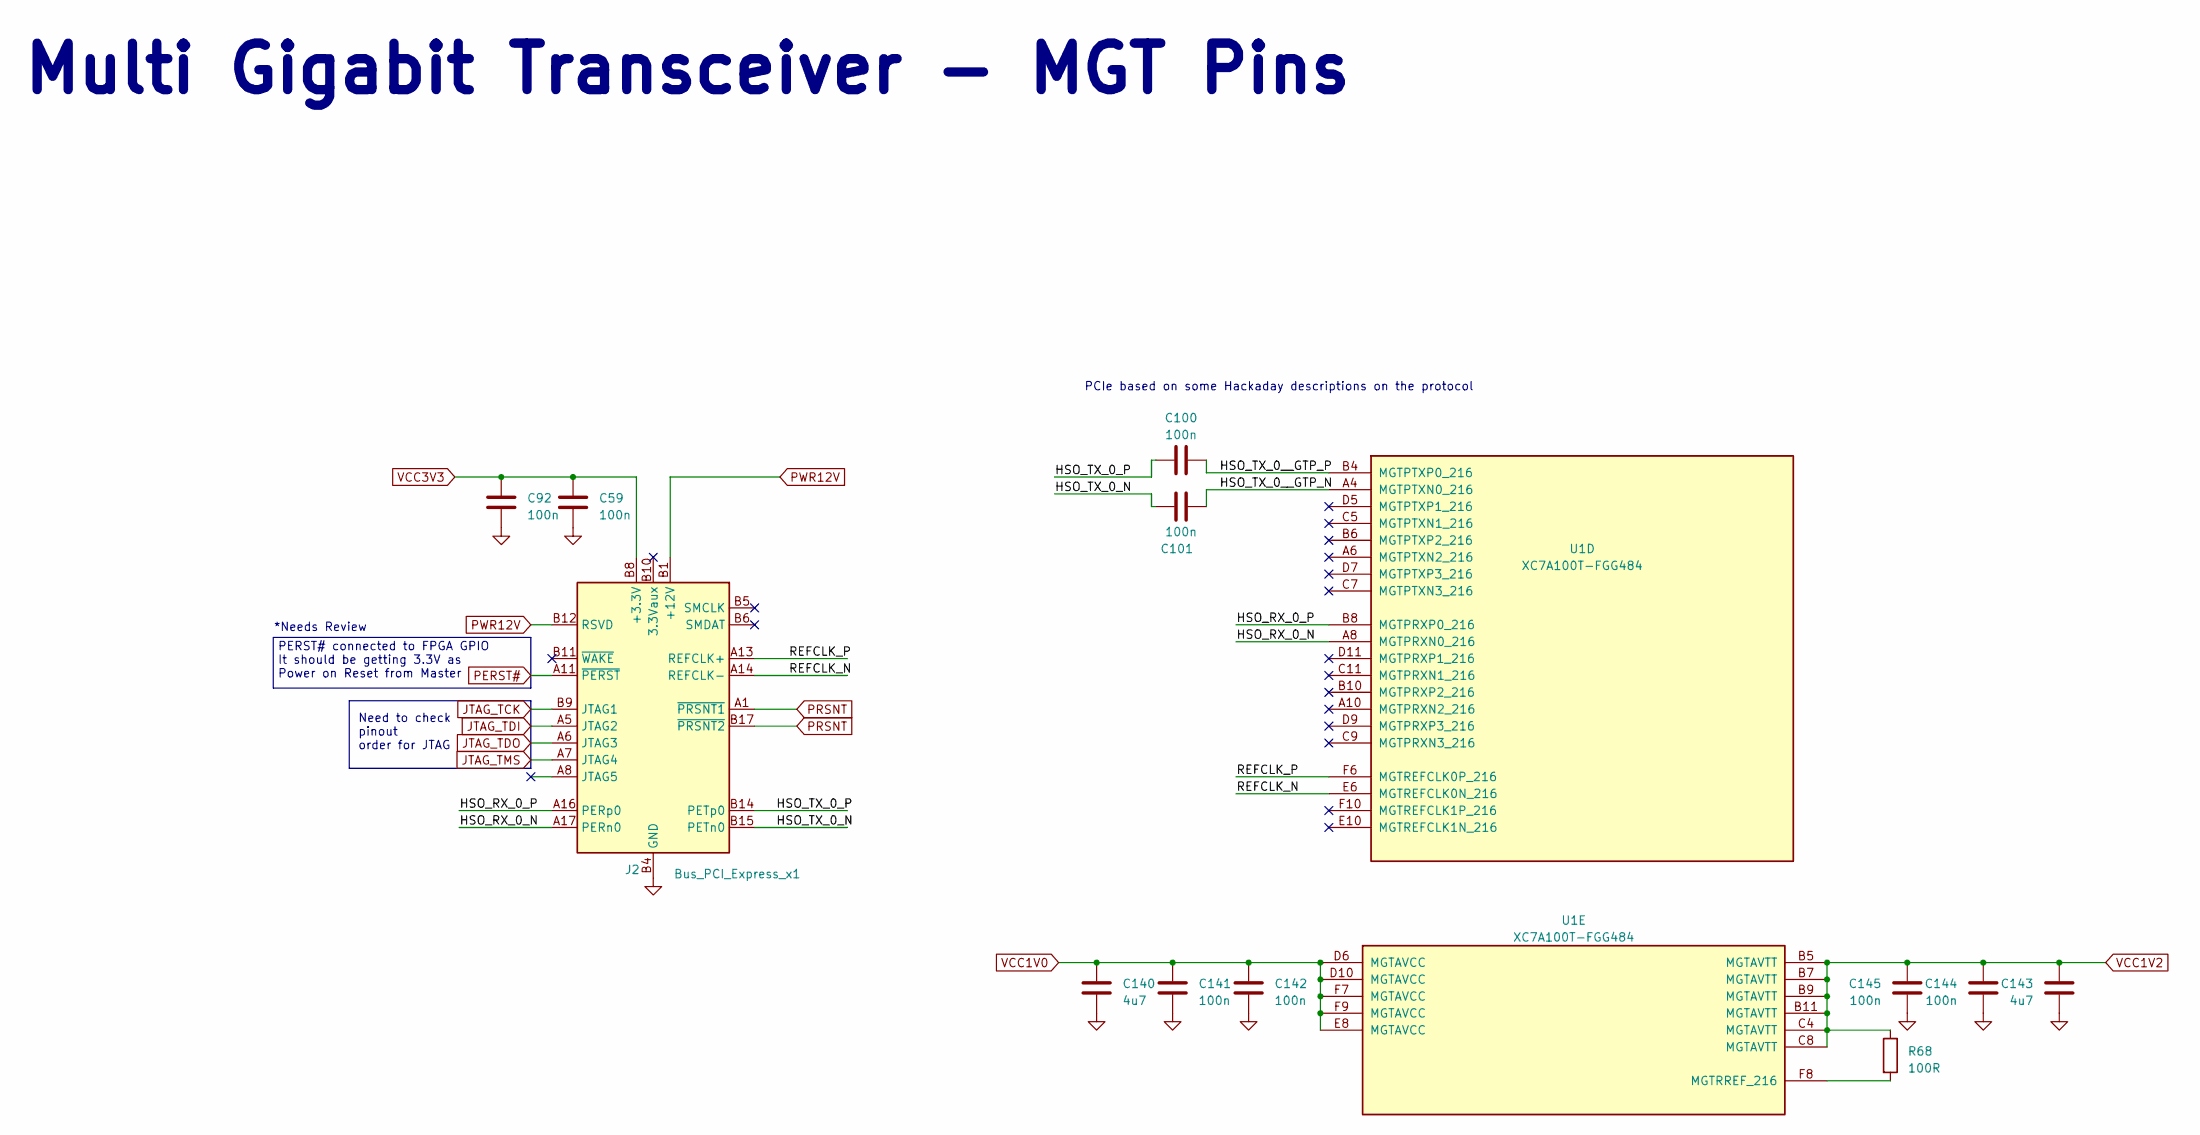
[picture p7: schematic fpga-unit-d.kicad_sch]

Parts:
C59, C92, C100, C101, C141, C142, C144, C145: 100n; G-155_MUR
C140, C143: 4u7; CAPC2012X140N
J2: Bus_PCI_Express_x1; BUS_PCIexpress_x1
R68: 100R; RESC1005X40
U1: XC7A100T-FGG484; BGA484C100P22X22_2300X2300X260N

Connections:
GND: C59.2, C92.2, C140.2, C141.2, C142.2, C143.2, C144.2, C145.2, J2.A4 (GND), J2.A12 (GND), J2.A15 (GND), J2.A18 (GND), J2.B4 (GND), J2.B7 (GND), J2.B13 (GND), J2.B16 (GND), J2.B18 (GND)
HSO_RX_0_N: J2.A17 (PERn0), U1.A8 (MGTPRXN0_216)
HSO_RX_0_P: J2.A16 (PERp0), U1.B8 (MGTPRXP0_216)
HSO_TX_0_N: C101.2, J2.B15 (PETn0)
HSO_TX_0_P: C100.2, J2.B14 (PETp0)
HSO_TX_0__GTP_N: C101.1, U1.A4 (MGTPTXN0_216)
HSO_TX_0__GTP_P: C100.1, U1.B4 (MGTPTXP0_216)
JTAG_TCK: J2.B9 (JTAG1)
JTAG_TDI: J2.A5 (JTAG2)
JTAG_TDO: J2.A6 (JTAG3)
JTAG_TMS: J2.A7 (JTAG4)
unnamed: R68.2, U1.F8 (MGTRREF_216)
PERST#: J2.A11 (~PERST)
PRSNT: J2.A1 (~PRSNT1), J2.B17 (~PRSNT2)
PWR12V: J2.A2 (+12V), J2.A3 (+12V), J2.B1 (+12V), J2.B2 (+12V), J2.B3 (+12V), J2.B12 (RSVD)
REFCLK_N: J2.A14 (REFCLK-), U1.E6 (MGTREFCLK0N_216)
REFCLK_P: J2.A13 (REFCLK+), U1.F6 (MGTREFCLK0P_216)
VCC1V0: C140.1, C141.1, C142.1, U1.D6 (MGTAVCC), U1.D10 (MGTAVCC), U1.E8 (MGTAVCC), U1.F7 (MGTAVCC), U1.F9 (MGTAVCC)
VCC1V2: C143.1, C144.1, C145.1, R68.1, U1.B5 (MGTAVTT), U1.B7 (MGTAVTT), U1.B9 (MGTAVTT), U1.B11 (MGTAVTT), U1.C4 (MGTAVTT), U1.C8 (MGTAVTT)
VCC3V3: C59.1, C92.1, J2.A9 (+3.3V), J2.A10 (+3.3V), J2.B8 (+3.3V)

Notes on the sheet:
Need to check pinout order for JTAG
*Needs Review
PERST# connected to FPGA GPIO It should be getting 3.3V as Power on Reset from Master
Multi Gigabit Transceiver - MGT Pins
PCIe based on some Hackaday descriptions on the protocol
