LZajmi/Artix-7-FPGA-Dev-Board/fpga-unit-f.kicad_sch

## KiCad design fpga-unit-f.kicad_sch (2024-09-25)

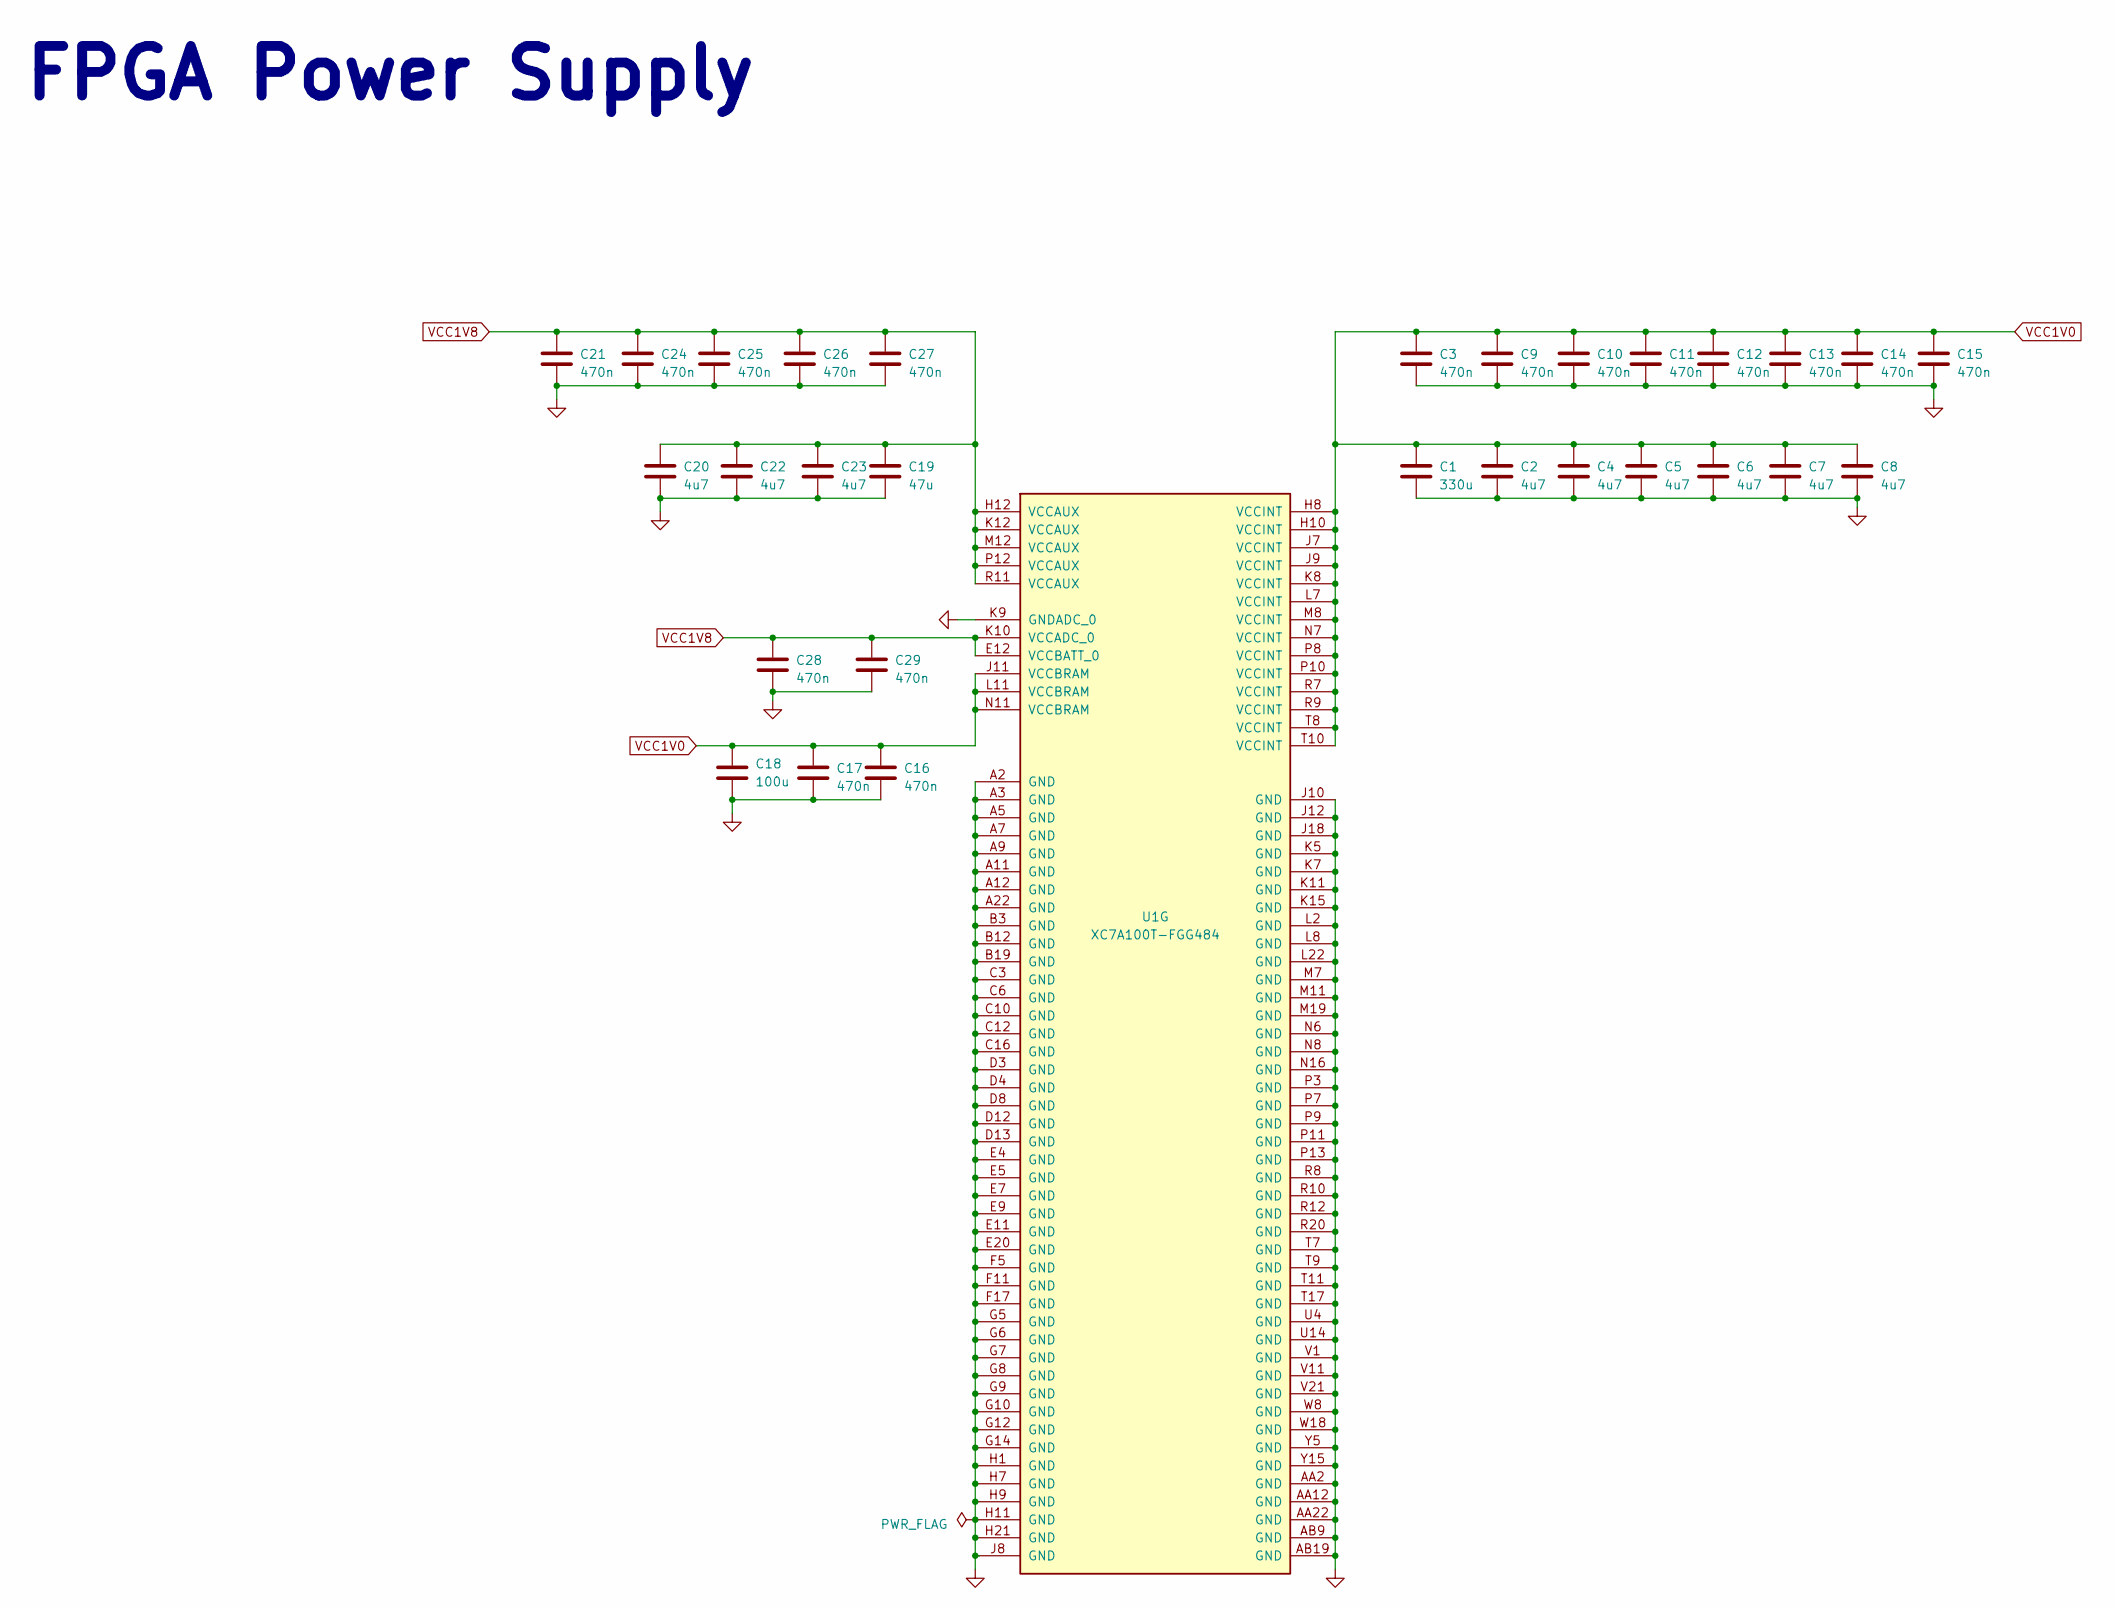
[picture p8: schematic fpga-unit-f.kicad_sch]

Parts:
C1: 330u; CAPMP7.6X4.3_1.9N_KEM
C2, C4, C5, C6, C7, C8, C20, C22, C23: 4u7; CAPC2012X140N
C3, C9, C10, C11, C12, C13, C14, C15, C16, C17, C21, C24, C25, C26, C27, C28, C29: 470n; CAPC1005X55N
C18: 100u; G-32_MUR
C19: 47u; G-32_MUR
U1: XC7A100T-FGG484; BGA484C100P22X22_2300X2300X260N

Connections:
GND: C1.2, C2.2, C3.2, C4.2, C5.2, C6.2, C7.2, C8.2, C9.2, C10.2, C11.2, C12.2, C13.2, C14.2, C15.2, C16.2, C17.2, C18.2, C19.2, C20.2, C21.2, C22.2, C23.2, C24.2, C25.2, C26.2, C27.2, C28.2, C29.2, U1.A2 (GND), U1.A3 (GND), U1.A5 (GND), U1.A7 (GND), U1.A9 (GND), U1.A11 (GND), U1.A12 (GND), U1.A22 (GND), U1.AA2 (GND), U1.AA12 (GND), U1.AA22 (GND), U1.AB9 (GND), U1.AB19 (GND), U1.B3 (GND), U1.B12 (GND), U1.B19 (GND), U1.C3 (GND), U1.C6 (GND), U1.C10 (GND), U1.C12 (GND), U1.C16 (GND), U1.D3 (GND), U1.D4 (GND), U1.D8 (GND), U1.D12 (GND), U1.D13 (GND), U1.E4 (GND), U1.E5 (GND), U1.E7 (GND), U1.E9 (GND), U1.E11 (GND), U1.E20 (GND), U1.F5 (GND), U1.F11 (GND), U1.F17 (GND), U1.G5 (GND), U1.G6 (GND), U1.G7 (GND), U1.G8 (GND), U1.G9 (GND), U1.G10 (GND), U1.G12 (GND), U1.G14 (GND), U1.H1 (GND), U1.H7 (GND), U1.H9 (GND), U1.H11 (GND), U1.H21 (GND), U1.J8 (GND), U1.J10 (GND), U1.J12 (GND), U1.J18 (GND), U1.K5 (GND), U1.K7 (GND), U1.K9 (GNDADC_0), U1.K11 (GND), U1.K15 (GND), U1.L2 (GND), U1.L8 (GND), U1.L22 (GND), U1.M7 (GND), U1.M11 (GND), U1.M19 (GND), U1.N6 (GND), U1.N8 (GND), U1.N16 (GND), U1.P3 (GND), U1.P7 (GND), U1.P9 (GND), U1.P11 (GND), U1.P13 (GND), U1.R8 (GND), U1.R10 (GND), U1.R12 (GND), U1.R20 (GND), U1.T7 (GND), U1.T9 (GND), U1.T11 (GND), U1.T17 (GND), U1.U4 (GND), U1.U14 (GND), U1.V1 (GND), U1.V11 (GND), U1.V21 (GND), U1.W8 (GND), U1.W18 (GND), U1.Y5 (GND), U1.Y15 (GND)
VCC1V0: C1.1, C2.1, C3.1, C4.1, C5.1, C6.1, C7.1, C8.1, C9.1, C10.1, C11.1, C12.1, C13.1, C14.1, C15.1, C16.1, C17.1, C18.1, U1.H8 (VCCINT), U1.H10 (VCCINT), U1.J7 (VCCINT), U1.J9 (VCCINT), U1.J11 (VCCBRAM), U1.K8 (VCCINT), U1.L7 (VCCINT), U1.L11 (VCCBRAM), U1.M8 (VCCINT), U1.N7 (VCCINT), U1.N11 (VCCBRAM), U1.P8 (VCCINT), U1.P10 (VCCINT), U1.R7 (VCCINT), U1.R9 (VCCINT), U1.T8 (VCCINT), U1.T10 (VCCINT)
VCC1V8: C19.1, C20.1, C21.1, C22.1, C23.1, C24.1, C25.1, C26.1, C27.1, C28.1, C29.1, U1.E12 (VCCBATT_0), U1.H12 (VCCAUX), U1.K10 (VCCADC_0), U1.K12 (VCCAUX), U1.M12 (VCCAUX), U1.P12 (VCCAUX), U1.R11 (VCCAUX)

Notes on the sheet:
FPGA Power Supply
