LZajmi/Artix-7-FPGA-Dev-Board/hdmi.kicad_sch

## KiCad design hdmi.kicad_sch (2024-09-25)

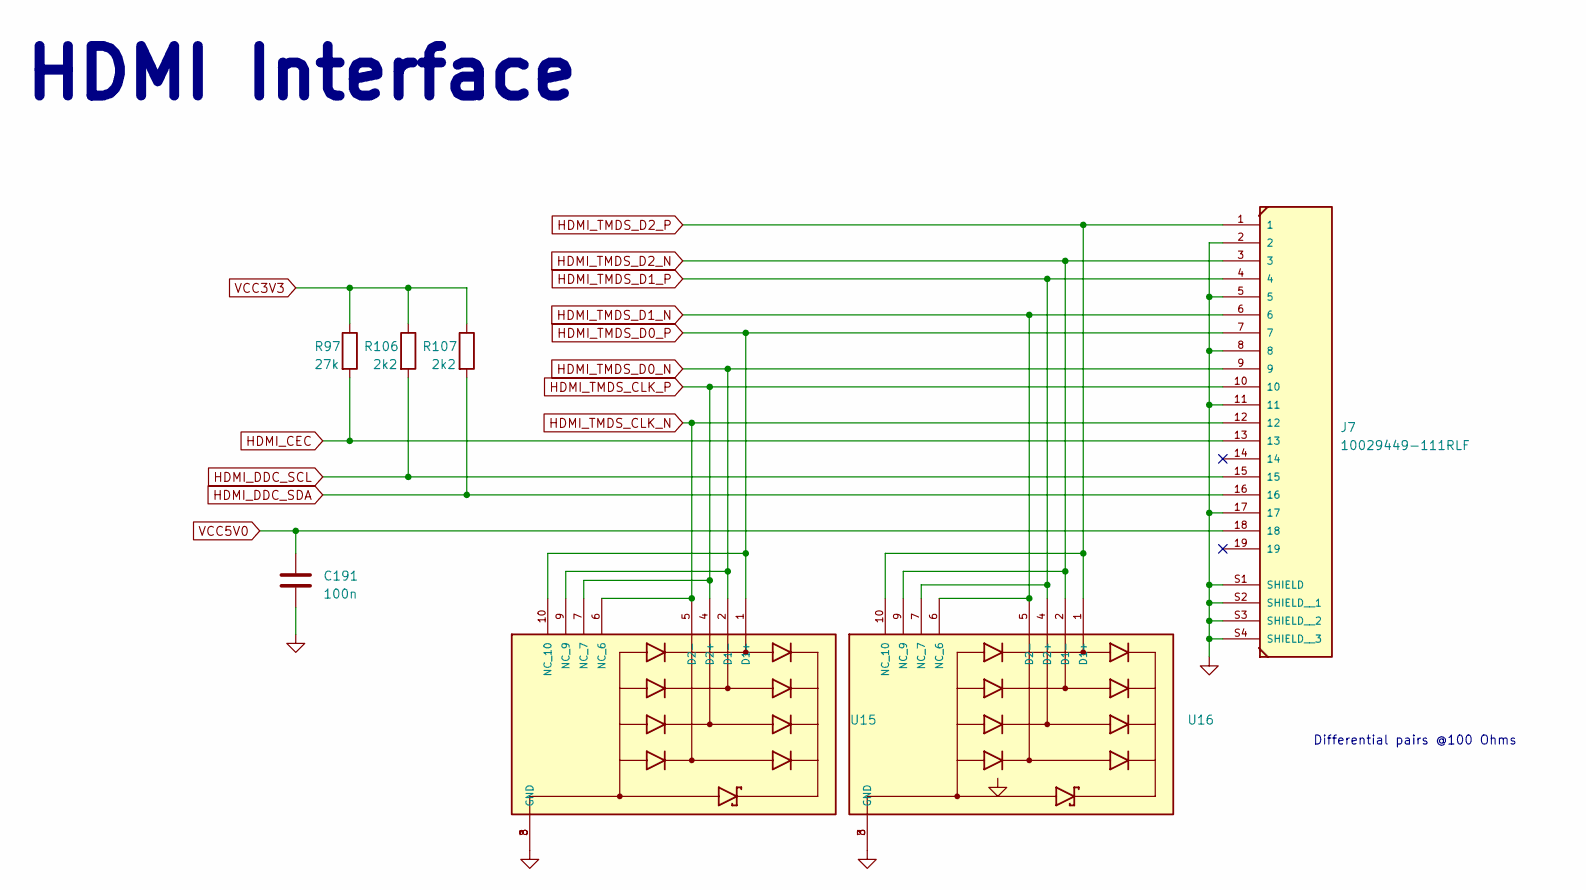
[picture p9: schematic hdmi.kicad_sch]

Parts:
C191: 100n; G-155_MUR
J7: 10029449-111RLF; AMPHENOL_10029449-111RLF; PARTREV Y
R97: 27k; RESC1005X35N
R106, R107: 2k2; RES_ERJ2RKF2201X
U15, U16: TPD4E05U06DQAR; IC_TPD4E05U06DQAR; PARTREV N

Connections:
GND: C191.2, J7.2, J7.5, J7.8, J7.11, J7.17, J7.S1 (SHIELD), J7.S2 (SHIELD__1), J7.S3 (SHIELD__2), J7.S4 (SHIELD__3), U15.3 (GND), U15.8 (GND), U16.3 (GND), U16.8 (GND)
HDMI_CEC: J7.13, R97.2
HDMI_DDC_SCL: J7.15, R106.2
HDMI_DDC_SDA: J7.16, R107.2
HDMI_TMDS_CLK_N: J7.12, U15.5 (D2-), U15.6 (NC_6)
HDMI_TMDS_CLK_P: J7.10, U15.4 (D2+), U15.7 (NC_7)
HDMI_TMDS_D0_N: J7.9, U15.2 (D1-), U15.9 (NC_9)
HDMI_TMDS_D0_P: J7.7, U15.1 (D1+), U15.10 (NC_10)
HDMI_TMDS_D1_N: J7.6, U16.5 (D2-), U16.6 (NC_6)
HDMI_TMDS_D1_P: J7.4, U16.4 (D2+), U16.7 (NC_7)
HDMI_TMDS_D2_N: J7.3, U16.2 (D1-), U16.9 (NC_9)
HDMI_TMDS_D2_P: J7.1, U16.1 (D1+), U16.10 (NC_10)
VCC3V3: R97.1, R106.1, R107.1
VCC5V0: C191.1, J7.18

Notes on the sheet:
Differential pairs @100 Ohms
HDMI Interface
