LZajmi/Artix-7-FPGA-Dev-Board/header.kicad_sch

## KiCad design header.kicad_sch (2024-09-25)

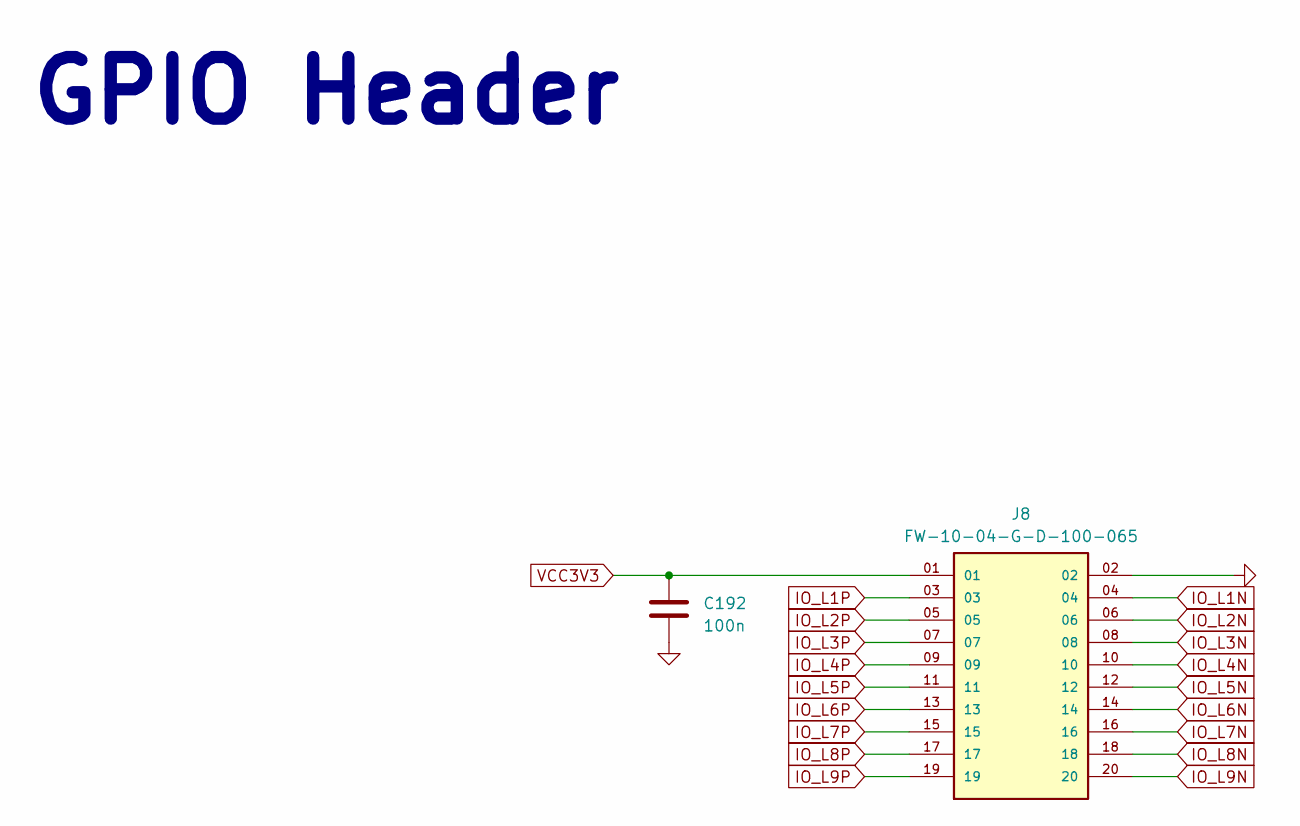
[picture p10: schematic header.kicad_sch]

Parts:
C192: 100n; G-155_MUR
J8: FW-10-04-G-D-100-065; SAMTEC_FW-10-04-G-D-100-065; PARTREV R

Connections:
GND: C192.2, J8.02
IO_L1N: J8.04
IO_L1P: J8.03
IO_L2N: J8.06
IO_L2P: J8.05
IO_L3N: J8.08
IO_L3P: J8.07
IO_L4N: J8.10
IO_L4P: J8.09
IO_L5N: J8.12
IO_L5P: J8.11
IO_L6N: J8.14
IO_L6P: J8.13
IO_L7N: J8.16
IO_L7P: J8.15
IO_L8N: J8.18
IO_L8P: J8.17
IO_L9N: J8.20
IO_L9P: J8.19
VCC3V3: C192.1, J8.01

Notes on the sheet:
GPIO Header
