LZajmi/Artix-7-FPGA-Dev-Board/power-supply.kicad_sch

## KiCad design power-supply.kicad_sch (2024-09-25)

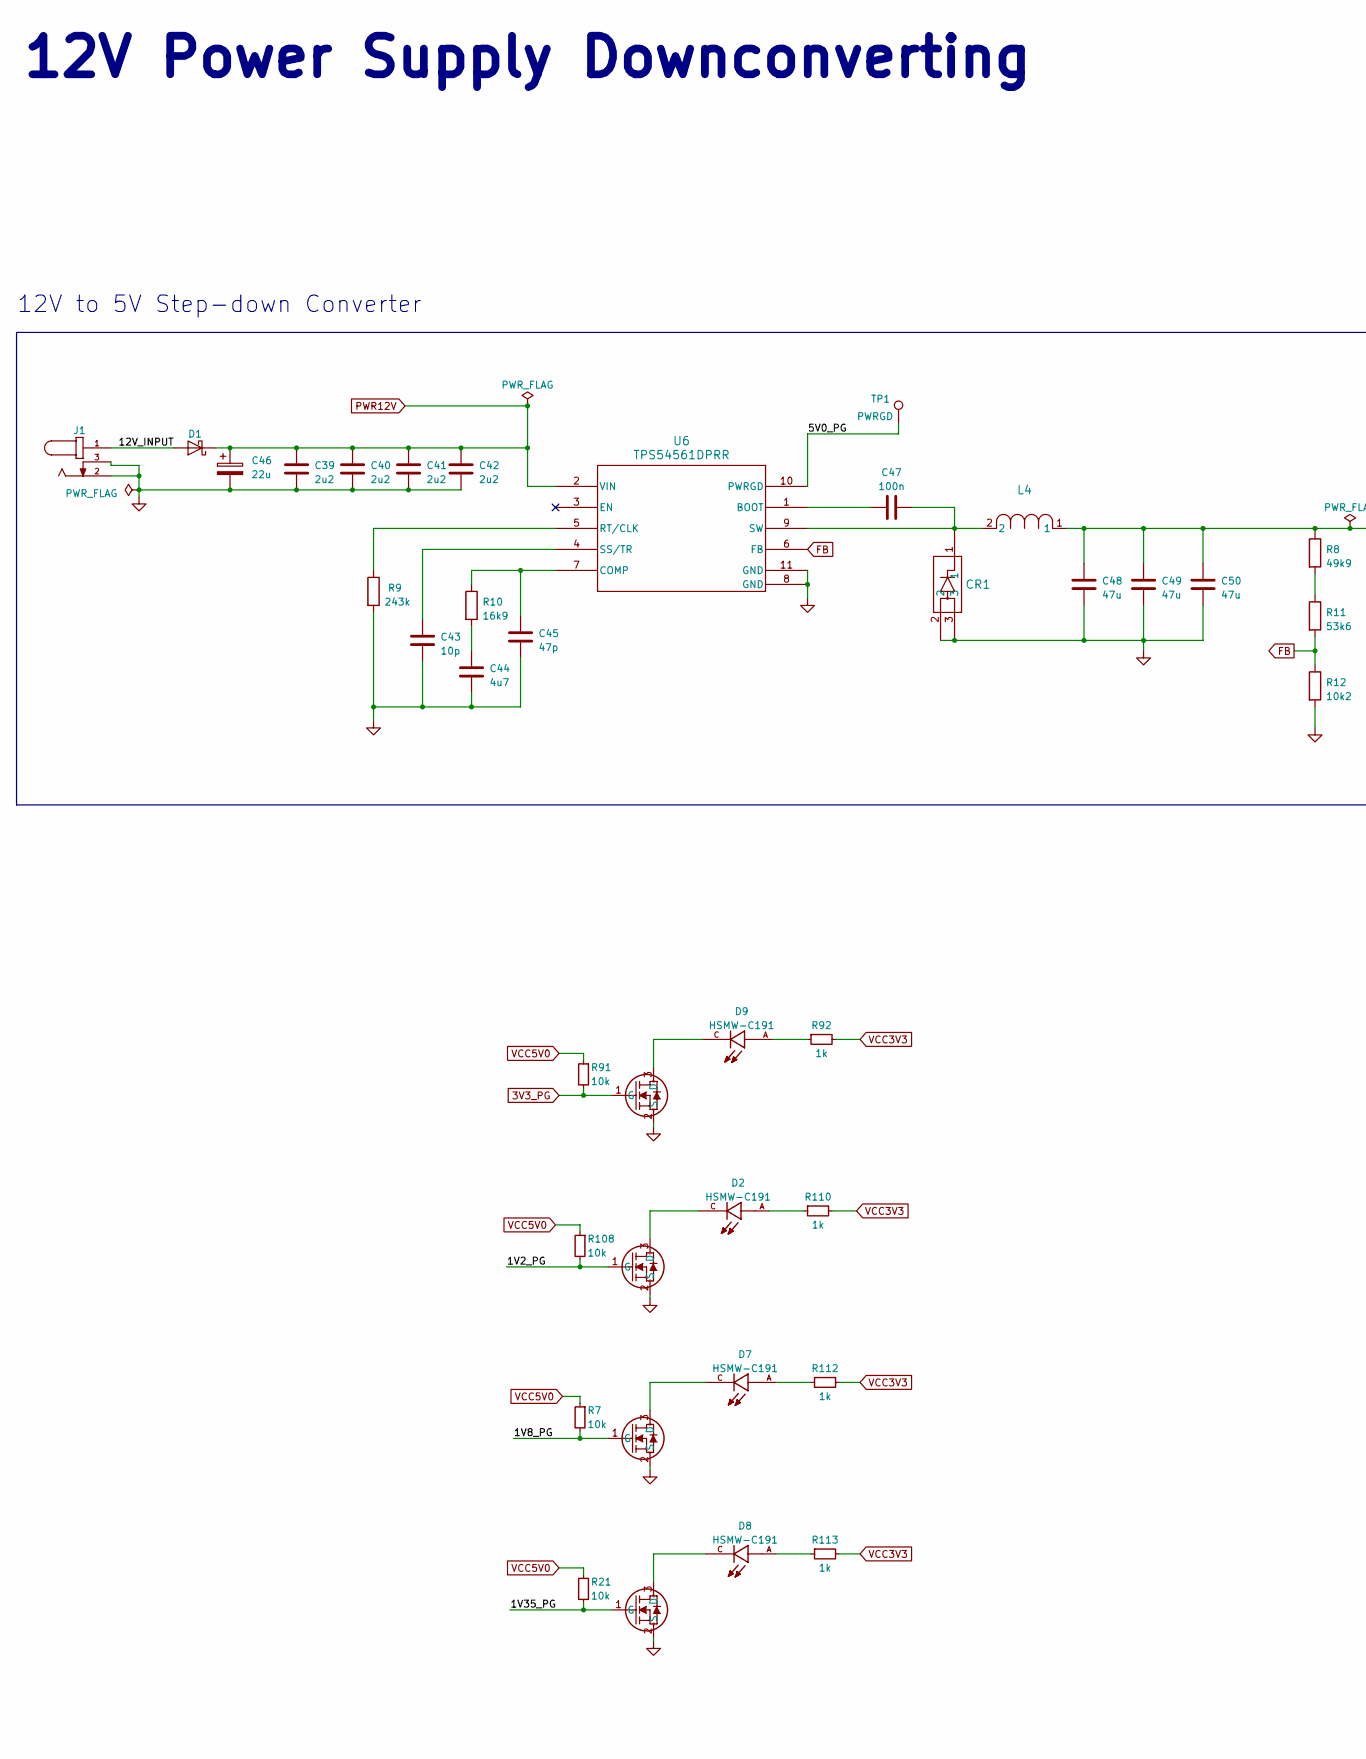
[picture p11: schematic power-supply.kicad_sch, part in row 1, column 1]

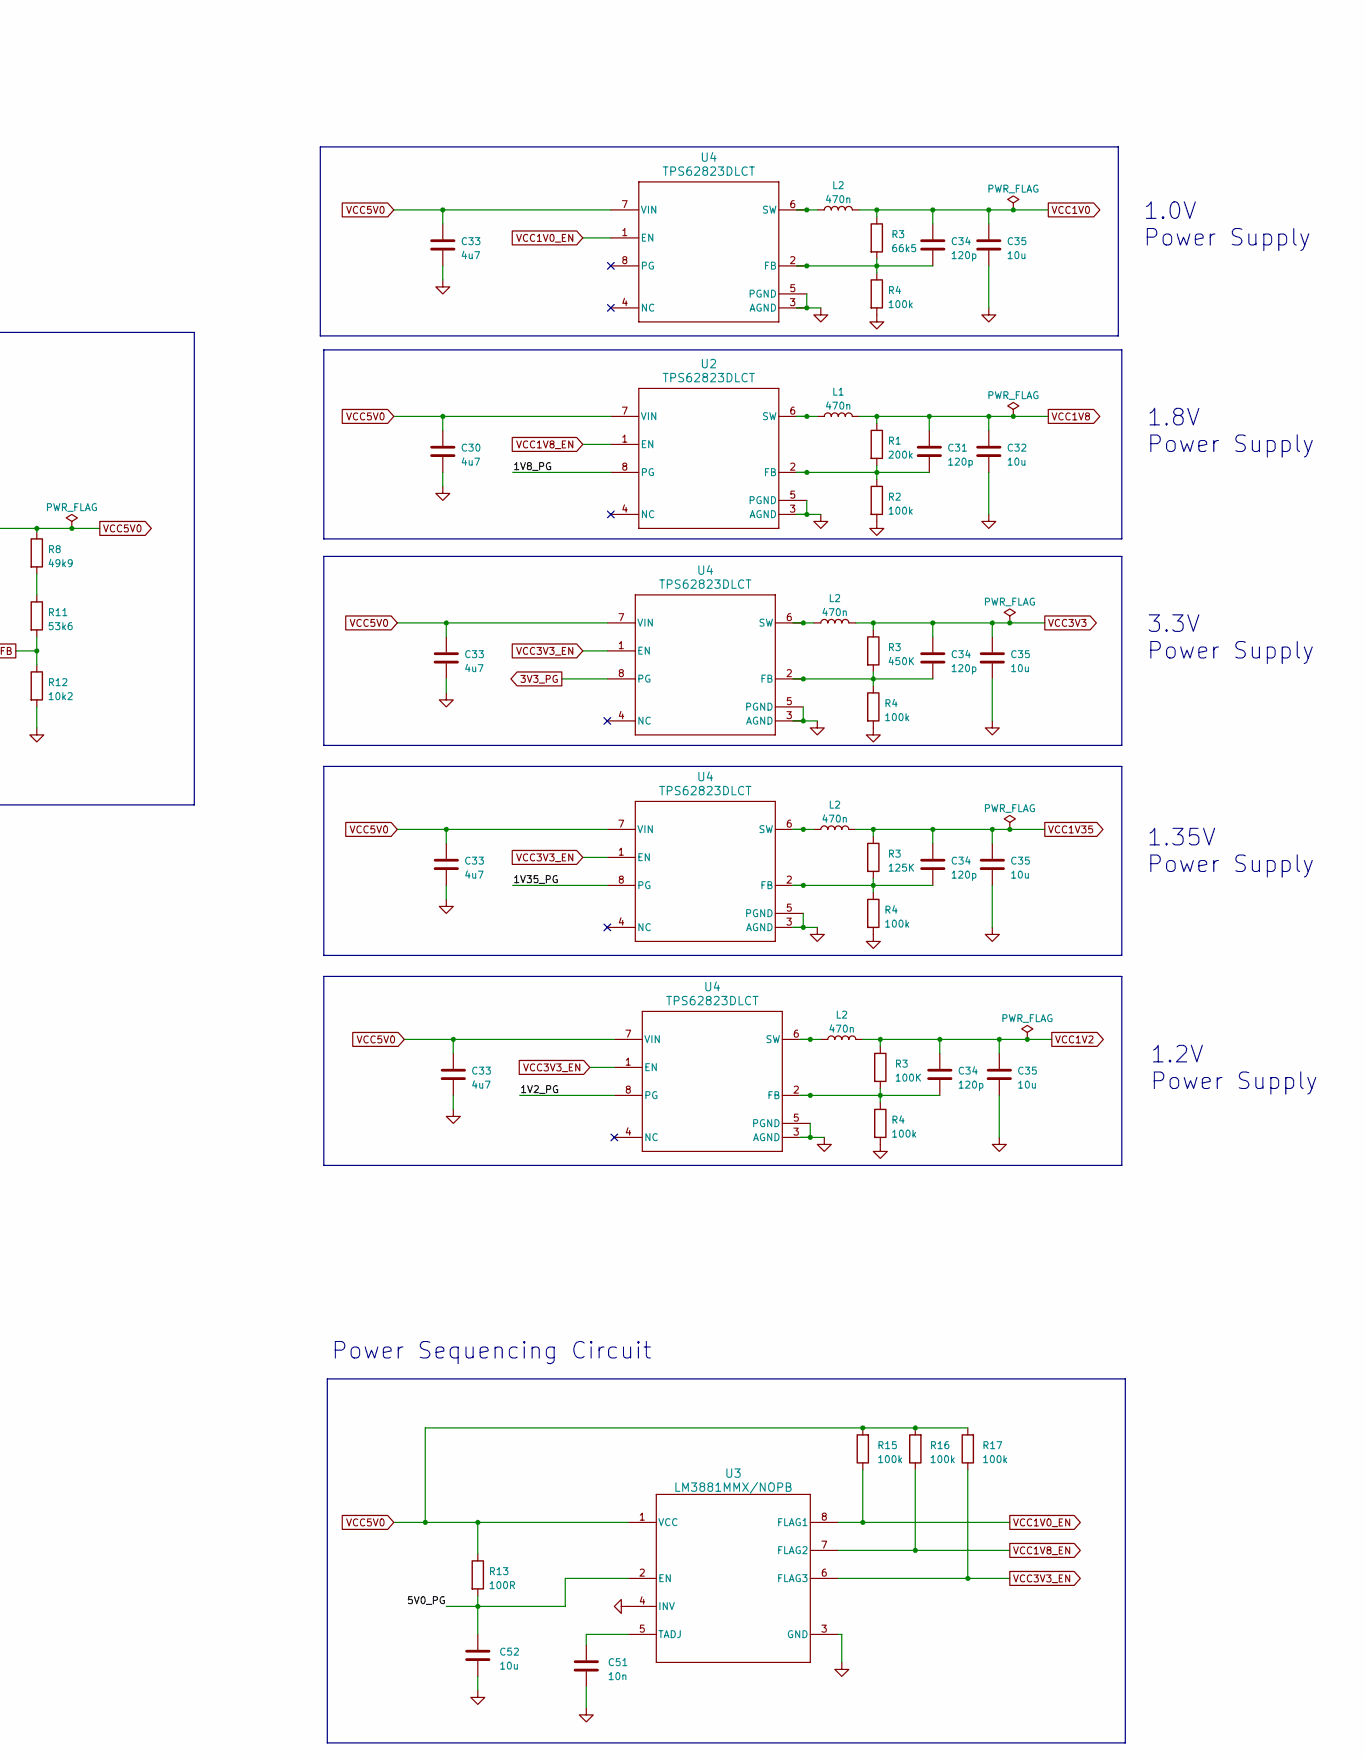
[picture p12: schematic power-supply.kicad_sch, part in row 1, column 2]

Parts:
C30, C33, C44: 4u7; CAPC2012X140N
C31, C34: 120p; G-188_MUR
C32, C35, C52: 10u; CAP_GRM155R60J106ME05D_MUR
C39, C40, C41, C42: 2u2; cap_UMK107ABJ474KA-T_TAY
C43: 10p; G-155_MUR
C45: 47p; G-155_MUR
C46: 22u; CAP_6.3 X 5.8_PAN
C47: 100n; G-155_MUR
C48, C49, C50: 47u; G-32_MUR
C51: 10n; CAPC1005X55N
CR1: PDS760-13; POWERDI5_DIO
D1: PMEG3020BER; Nexperia_CFP3_SOD-123W
D2, D7, D8, D9: HSMW-C191; LEDSC80X160X70-2N; PARTREV N/A
J1: DCJ200-10-A-XX-K_REVA; BarrelJack_GCT_DCJ200-10-A_Horizontal; PARTREV A
L1, L2: 470n; XFL4012
L4: 7447798720; IND_1064_WE-PDF_WRE
MOSFET1, MOSFET2, MOSFET3, MOSFET6: BSS138PW_115; SC-70_SOT323_NEX
R1: 200k; RC0603N_PAN
R2, R4, R15, R16, R17: 100k; RESC1608X55
R3: 66k5; RESC1005X35N
R7, R21, R91, R108: R_10k_0402; RESC1005X40N; Tolerance 1%; MPN CR0402-FX-1002GLF
R8: 49k9; RESC1608X60N
R9: 243k; RESC1608X55N
R10: 16k9; RESC1608X55N
R11: 53k6; 0603
R12: 10k2; RESC1608X55N
R13: 100R; RESC1005X40
R92, R110, R112, R113: R_1k_0402; RESC1607X60N; Tolerance 1%; MPN CR0402-FX-1001GLF
TP1: PWRGD; TestPoint_Pad_D1.5mm
U2, U4: TPS62823DLCT; DLC0008A
U3: LM3881MMX/NOPB; DGK0008A_N
U6: TPS54561DPRR; WSON10_DPR_TEX

Connections:
1V2_PG: MOSFET2.1 (G), R108.2, U4.8 (PG)
1V8_PG: MOSFET1.1 (G), R7.2, U2.8 (PG)
1V35_PG: MOSFET3.1 (G), R21.2, U4.8 (PG)
3V3_PG: MOSFET6.1 (G), R91.2, U4.8 (PG)
5V0_PG: C52.1, R13.2, TP1.1, U3.2 (EN), U6.10 (PWRGD)
12V_INPUT: D1.2 (A), J1.1
FB: R11.2, R12.1, U6.6 (FB)
GND: C30.2, C32.2, C33.2, C35.2, C39.2, C40.2, C41.2, C42.2, C43.2, C44.2, C45.2, C46.2, C48.2, C49.2, C50.2, C51.2, C52.2, CR1.2, CR1.3, J1.2, J1.3, MOSFET1.2 (S), MOSFET2.2 (S), MOSFET3.2 (S), MOSFET6.2 (S), R2.2, R4.2, R9.2, R12.2, U2.3 (AGND), U2.5 (PGND), U3.3 (GND), U3.4 (INV), U4.3 (AGND), U4.5 (PGND), U6.8 (GND), U6.11 (GND)
unnamed: C31.2, R1.2, R2.1, U2.2 (FB)
unnamed: C34.2, R3.2, R4.1, U4.2 (FB)
unnamed: C43.1, U6.4 (SS/TR)
unnamed: C44.1, R10.2
unnamed: C45.1, R10.1, U6.7 (COMP)
unnamed: C47.1, CR1.1, L4.2, U6.9 (SW)
unnamed: C47.2, U6.1 (BOOT)
unnamed: C51.1, U3.5 (TADJ)
unnamed: D2.A, R110.1
unnamed: D2.C, MOSFET2.3 (D)
unnamed: D7.A, R112.1
unnamed: D7.C, MOSFET1.3 (D)
unnamed: D8.A, R113.1
unnamed: D8.C, MOSFET3.3 (D)
unnamed: D9.A, R92.1
unnamed: D9.C, MOSFET6.3 (D)
unnamed: L1.1, U2.6 (SW)
unnamed: L2.1, U4.6 (SW)
unnamed: R9.1, U6.5 (RT/CLK)
unnamed: R8.2, R11.1
PWR12V: C39.1, C40.1, C41.1, C42.1, C46.1, D1.1 (K), U6.2 (VIN)
VCC1V0: C34.1, C35.1, L2.2, R3.1
VCC1V0_EN: R15.1, U3.8 (FLAG1), U4.1 (EN)
VCC1V2: C34.1, C35.1, L2.2, R3.1
VCC1V8: C31.1, C32.1, L1.2, R1.1
VCC1V8_EN: R16.1, U2.1 (EN), U3.7 (FLAG2)
VCC1V35: C34.1, C35.1, L2.2, R3.1
VCC3V3: C34.1, C35.1, L2.2, R3.1, R92.2, R110.2, R112.2, R113.2
VCC3V3_EN: R17.1, U3.6 (FLAG3), U4.1 (EN)
VCC5V0: C30.1, C33.1, C48.1, C49.1, C50.1, L4.1, R7.1, R8.1, R13.1, R15.2, R16.2, R17.2, R21.1, R91.1, R108.1, U2.7 (VIN), U3.1 (VCC), U4.7 (VIN)

Notes on the sheet:
1.8V Power Supply
Power Sequencing Circuit
1.35V Power Supply
12V to 5V Step-down Converter
12V Power Supply Downconverting
3.3V Power Supply
1.0V Power Supply
1.2V Power Supply
