LZajmi/Artix-7-FPGA-Dev-Board/qspi_flash.kicad_sch

## KiCad design qspi_flash.kicad_sch (2024-09-25)

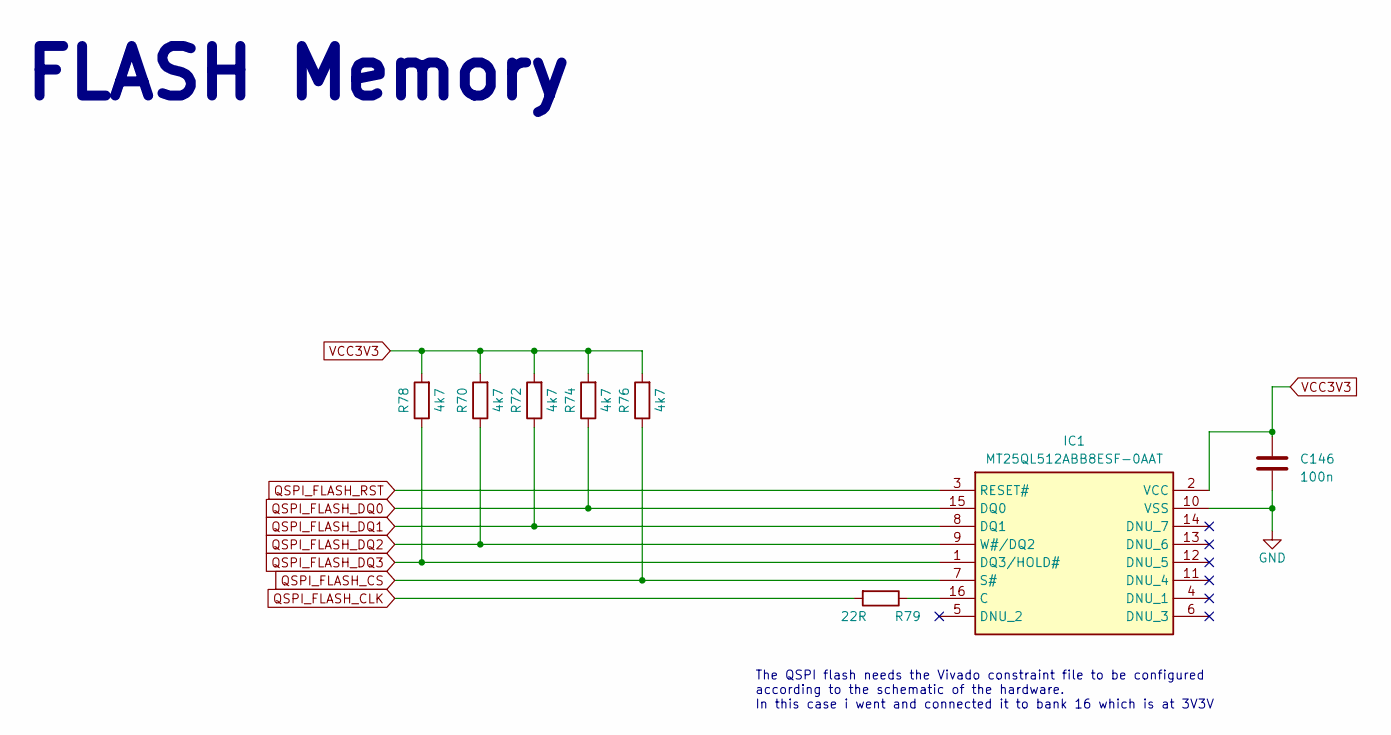
[picture p13: schematic qspi_flash.kicad_sch]

Parts:
C146: 100n; G-155_MUR
IC1: MT25QL512ABB8ESF-0AAT; SOIC127P1032X265-16N; Mouser Part Number 340-285789-TRAY
R70, R72, R74, R76, R78: 4k7; RESC1005X40
R79: 22R; RC0402N_YAG

Connections:
GND: C146.2, IC1.10 (VSS)
unnamed: IC1.16 (C), R79.1
QSPI_FLASH_CLK: R79.2
QSPI_FLASH_CS: IC1.7 (S#), R76.1
QSPI_FLASH_DQ0: IC1.15 (DQ0), R74.1
QSPI_FLASH_DQ1: IC1.8 (DQ1), R72.1
QSPI_FLASH_DQ2: IC1.9 (W#/DQ2), R70.1
QSPI_FLASH_DQ3: IC1.1 (DQ3/HOLD#), R78.1
QSPI_FLASH_RST: IC1.3 (RESET#)
VCC3V3: C146.1, IC1.2 (VCC), R70.2, R72.2, R74.2, R76.2, R78.2

Notes on the sheet:
The QSPI flash needs the Vivado constraint file to be configured according to the schematic of the hardware. In this case i went and connected it to bank 16 which is at 3V3V
FLASH Memory
