LZajmi/Artix-7-FPGA-Dev-Board/usb.kicad_sch

## KiCad design usb.kicad_sch (2024-09-25)

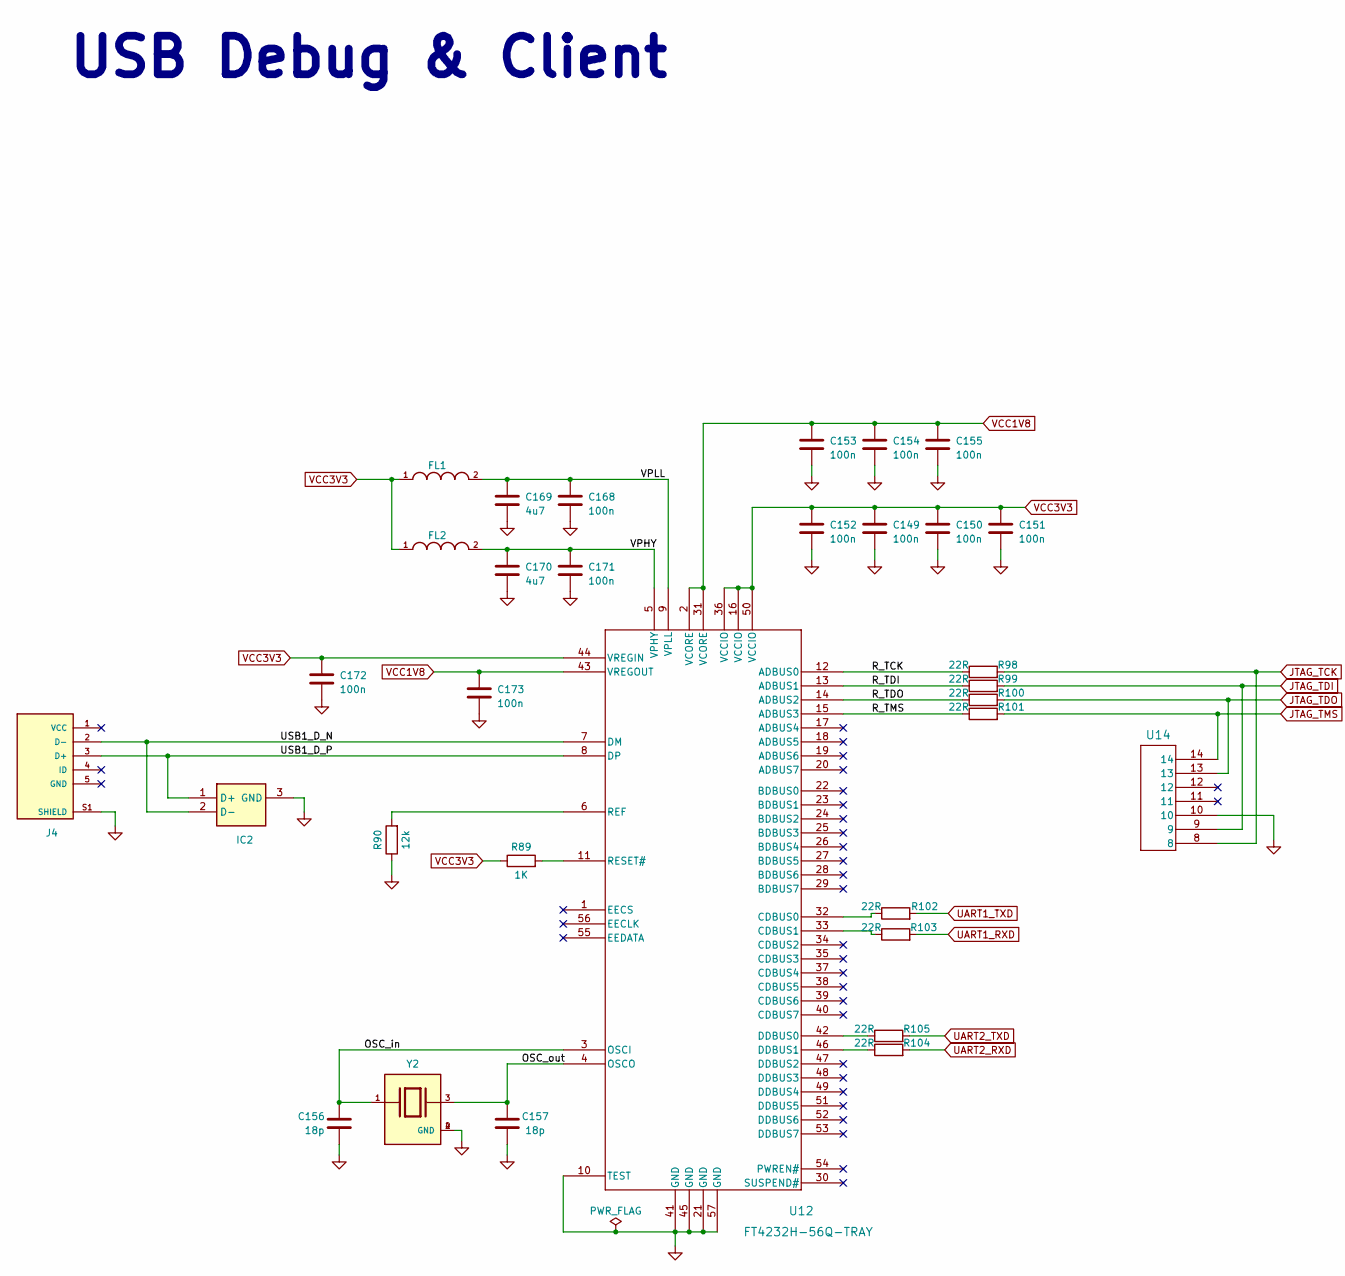
[picture p14: schematic usb.kicad_sch, part in row 1, column 1]

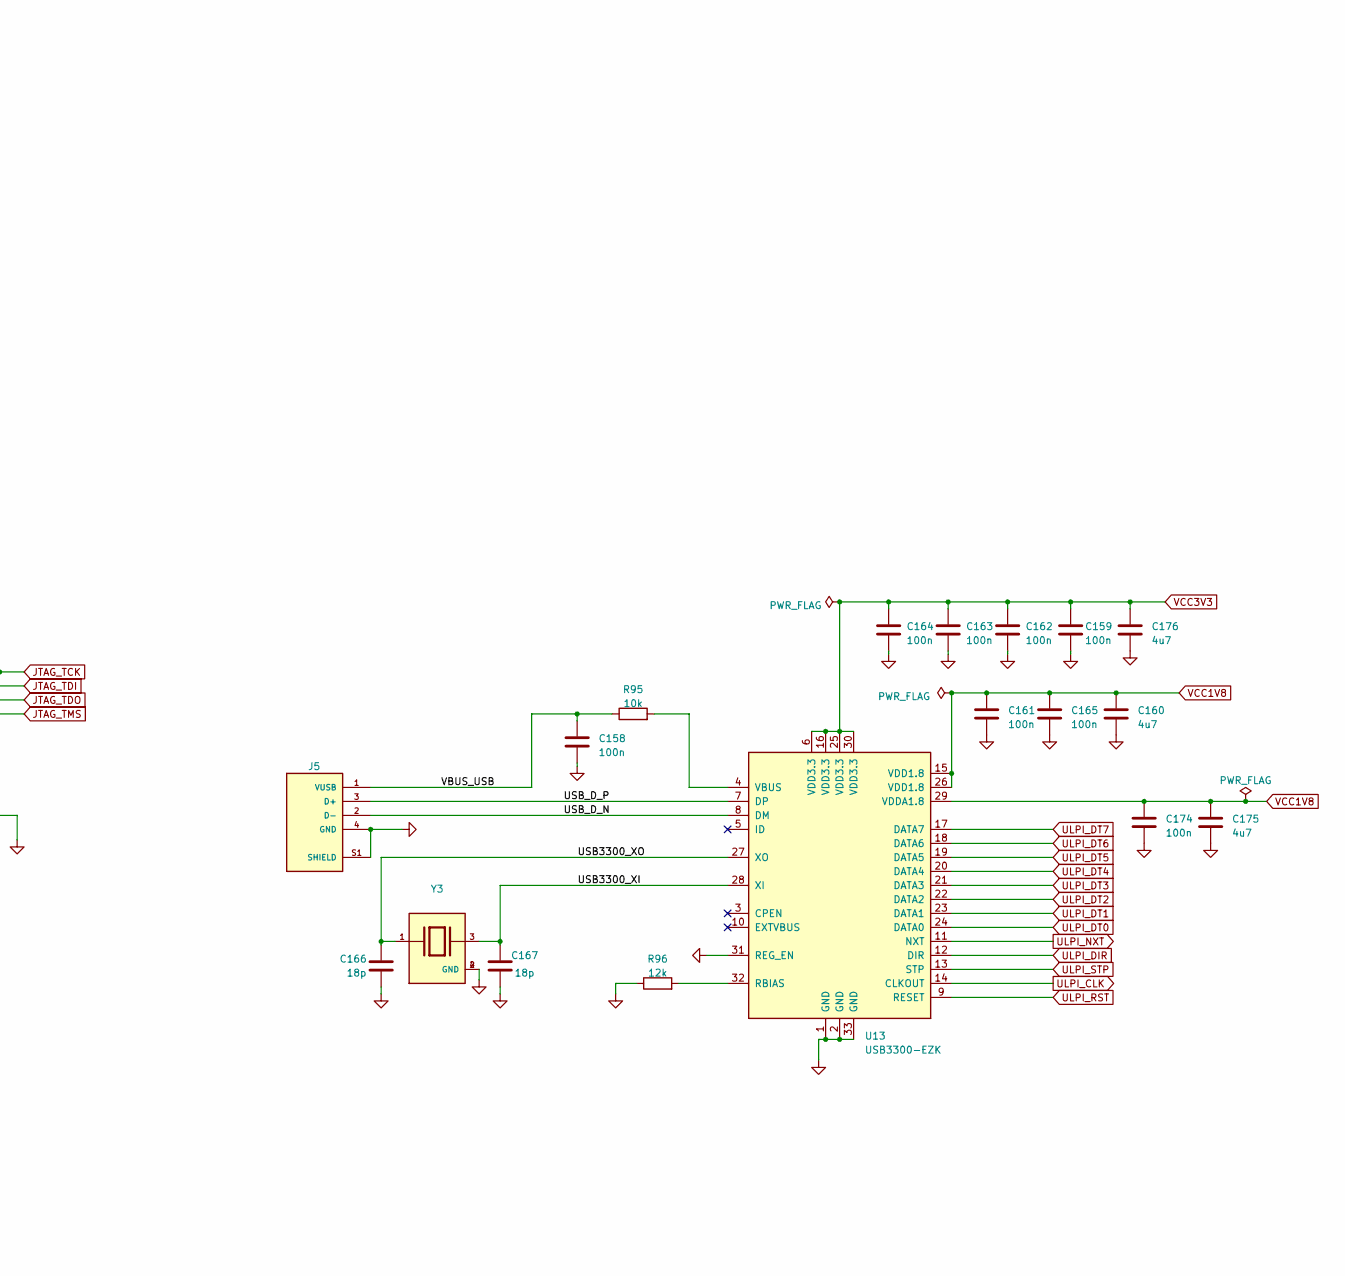
[picture p15: schematic usb.kicad_sch, part in row 1, column 2]

Parts:
C149, C150, C151, C152, C153, C154, C155, C158, C159, C161, C162, C163, C164, C165, C168, C171, C172, C173, C174: 100n; G-155_MUR
C156, C157, C166, C167: 18p; CAPC1005X55N
C160, C169, C170, C175, C176: 4u7; CAPC2012X140N
FL1, FL2: BLM15AG601SN1D; BEADC1005X55N
IC2: TPD2E009DBZR; SOT95P237X112-3N; Mouser Part Number 595-TPD2E009DBZR
J4: 10118192-0002LF; AMPHENOL_10118192-0002LF; PARTREV B
J5: USB-A1VSB6; ONSHORE_USB-A1VSB6; PARTREV D
R89: 1K; RESC1607X60N
R90, R96: 12k; RESC1005X40N
R95: 10k; RESC1005X40N
R98, R99, R100, R101, R102, R103, R104, R105: 22R; RC0402N_YAG
U12: FT4232H-56Q-TRAY; VQFN56_FTD
U13: USB3300-EZK; QFN-32-1EP_5x5mm_P0.5mm_EP3.45x3.45mm
U14: SP3011-06UTG; SON14_SP3011-06UTG_LTF
Y2: ABM8G-12.000MHZ-18-D2Y-T; XTAL_ABM8G-12.000MHZ-18-D2Y-T; PARTREV 08.13.15
Y3: ABM8-24.000MHZ-B2-T; XTAL_ABM8-24.000MHZ-B2-T; PARTREV 44041

Connections:
GND: C149.2, C150.2, C151.2, C152.2, C153.2, C154.2, C155.2, C156.2, C157.2, C158.2, C159.2, C160.2, C161.2, C162.2, C163.2, C164.2, C165.2, C166.2, C167.2, C168.2, C169.2, C170.2, C171.2, C172.2, C173.2, C174.2, C175.2, C176.2, IC2.3 (GND), J4.S1 (SHIELD), J4.S2 (SHIELD__1), J4.S3 (SHIELD__2), J4.S4 (SHIELD__3), J4.S5 (SHIELD__4), J4.S6 (SHIELD__5), J5.4 (GND), J5.S1 (SHIELD), J5.S2 (SHIELD__1), R90.1, R96.1, U12.10 (TEST), U12.21 (GND), U12.41 (GND), U12.45 (GND), U12.57 (GND), U13.1 (GND), U13.2 (GND), U13.31 (REG_EN), U13.33 (GND), U14.5, U14.10, Y2.2 (GND), Y2.4 (GND), Y3.2 (GND), Y3.4 (GND)
JTAG_TCK: R98.2, U14.7, U14.8
JTAG_TDI: R99.2, U14.6, U14.9
JTAG_TDO: R100.2, U14.2, U14.13
JTAG_TMS: R101.2, U14.1, U14.14
unnamed: R89.2, U12.11 (RESET#)
unnamed: R90.2, U12.6 (REF)
unnamed: R95.2, U13.4 (VBUS)
unnamed: R96.2, U13.32 (RBIAS)
unnamed: R102.1, U12.32 (CDBUS0)
unnamed: R103.1, U12.33 (CDBUS1)
unnamed: R104.1, U12.46 (DDBUS1)
unnamed: R105.1, U12.42 (DDBUS0)
unnamed: U14.4, U14.11
unnamed: U14.3, U14.12
OSC_in: C156.1, U12.3 (OSCI), Y2.1
OSC_out: C157.1, U12.4 (OSCO), Y2.3
R_TCK: R98.1, U12.12 (ADBUS0)
R_TDI: R99.1, U12.13 (ADBUS1)
R_TDO: R100.1, U12.14 (ADBUS2)
R_TMS: R101.1, U12.15 (ADBUS3)
UART1_RXD: R103.2
UART1_TXD: R102.2
UART2_RXD: R104.2
UART2_TXD: R105.2
ULPI_CLK: U13.14 (CLKOUT)
ULPI_DIR: U13.12 (DIR)
ULPI_DT0: U13.24 (DATA0)
ULPI_DT1: U13.23 (DATA1)
ULPI_DT2: U13.22 (DATA2)
ULPI_DT3: U13.21 (DATA3)
ULPI_DT4: U13.20 (DATA4)
ULPI_DT5: U13.19 (DATA5)
ULPI_DT6: U13.18 (DATA6)
ULPI_DT7: U13.17 (DATA7)
ULPI_NXT: U13.11 (NXT)
ULPI_RST: U13.9 (RESET)
ULPI_STP: U13.13 (STP)
USB1_D_N: IC2.2 (D-), J4.2 (D-), U12.7 (DM)
USB1_D_P: IC2.1 (D+), J4.3 (D+), U12.8 (DP)
USB3300_XI: C167.1, U13.28 (XI), Y3.3
USB3300_XO: C166.1, U13.27 (XO), Y3.1
USB_D_N: J5.2 (D-), U13.8 (DM)
USB_D_P: J5.3 (D+), U13.7 (DP)
VBUS_USB: C158.1, J5.1 (VUSB), R95.1
VCC1V8: C153.1, C154.1, C155.1, C160.1, C161.1, C165.1, C173.1, C174.1, C175.1, U12.2 (VCORE), U12.31 (VCORE), U12.43 (VREGOUT), U13.15 (VDD1.8), U13.26 (VDD1.8), U13.29 (VDDA1.8)
VCC3V3: C149.1, C150.1, C151.1, C152.1, C159.1, C162.1, C163.1, C164.1, C172.1, C176.1, FL1.1, FL2.1, R89.1, U12.16 (VCCIO), U12.36 (VCCIO), U12.44 (VREGIN), U12.50 (VCCIO), U13.6 (VDD3.3), U13.16 (VDD3.3), U13.25 (VDD3.3), U13.30 (VDD3.3)
VPHY: C170.1, C171.1, FL2.2, U12.5 (VPHY)
VPLL: C168.1, C169.1, FL1.2, U12.9 (VPLL)

Notes on the sheet:
USB Debug & Client
