LZajmi/Artix-7-FPGA-Dev-Board/(commit log)

2024-09-24 File Upload
    Kicad Files Upload
    [FPGA_dev_board.kicad_sch, component list.xlsx, ddr3.kicad_sch, ethernet.kicad_sch, fpga-banks-13-16.kicad_sch, fpga-unit-b.kicad_sch, fpga-unit-c.kicad_sch, fpga-unit-d.kicad_sch]
2024-09-24 Board Changes
    [FPGA_dev_board-B_Cu.gbr, FPGA_dev_board-B_Mask.gbr, FPGA_dev_board-B_Paste.gbr, FPGA_dev_board-B_Silkscreen.gbr, FPGA_dev_board-Edge_Cuts.gbr, FPGA_dev_board-F_Cu.gbr, FPGA_dev_board-F_Mask.gbr, FPGA_dev_board-F_Paste.gbr]
2024-09-24 Gerber Files v2
    [FPGA_dev_board-B_Cu.gbr, FPGA_dev_board-B_Mask.gbr, FPGA_dev_board-B_Paste.gbr, FPGA_dev_board-B_Silkscreen.gbr, FPGA_dev_board-Edge_Cuts.gbr, FPGA_dev_board-F_Cu.gbr, FPGA_dev_board-F_Mask.gbr, FPGA_dev_board-F_Paste.gbr]
2024-09-24 File Cleaning
    [FPGA_dev_board-B_Cu.gbr, FPGA_dev_board-B_Mask.gbr, FPGA_dev_board-B_Paste.gbr, FPGA_dev_board-B_Silkscreen.gbr, FPGA_dev_board-Edge_Cuts.gbr, FPGA_dev_board-F_Cu.gbr, FPGA_dev_board-F_Mask.gbr, FPGA_dev_board-F_Paste.gbr]
2024-09-25 Schematic Update
    [FPGA_dev_board-B_Cu.gbr, FPGA_dev_board-B_Mask.gbr, FPGA_dev_board-B_Paste.gbr, FPGA_dev_board-B_Silkscreen.gbr, FPGA_dev_board-Edge_Cuts.gbr, FPGA_dev_board-F_Cu.gbr, FPGA_dev_board-F_Mask.gbr, FPGA_dev_board-F_Paste.gbr]
2024-09-26 Edge Cut Update
2024-09-26 Power Plane Update
2024-09-26 Power plane update v2
2024-09-29 Power Via update
