LZajmi/Artix-7-FPGA-Dev-Board/(notices)

Notices in the files:
parts and their libraries:
License: Apache-2.0
